sadekbaroudi/vik/pcb/vik-splitter/vik-splitter.kicad_pcb

## KiCad design pcb/vik-splitter/vik-splitter.kicad_pcb (2025-03-19)

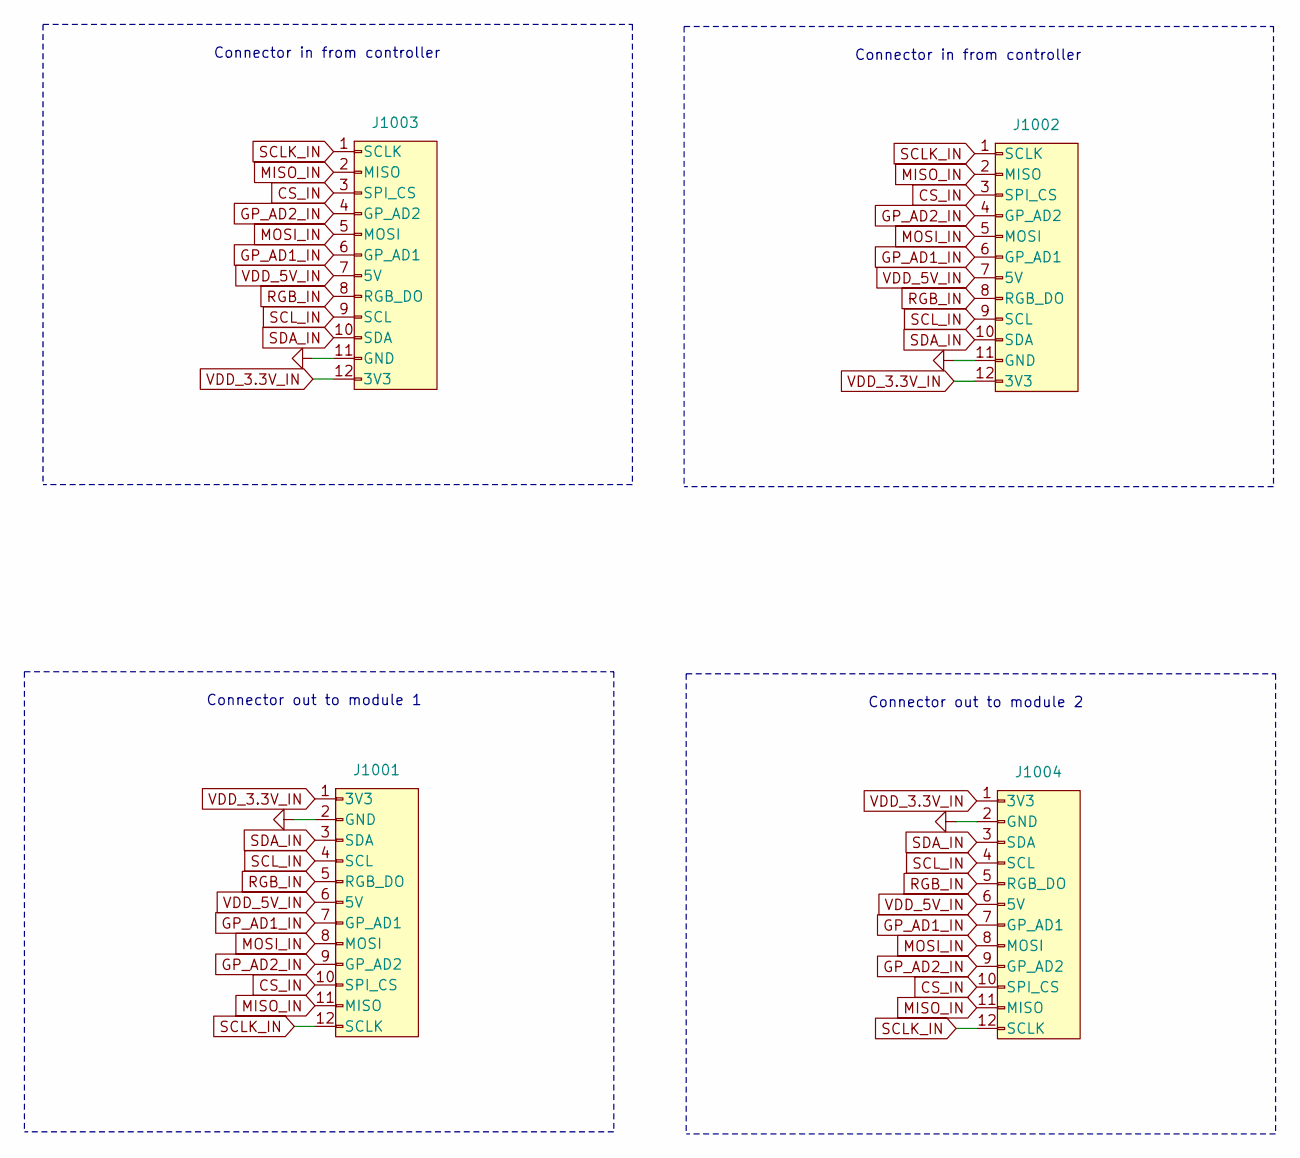
[picture p4: schematic vik-splitter.kicad_sch]

Parts:
J1001, J1004: vik-keyboard-connector-horizontal; LCSC C2919557
J1002: vik-module-throughole; LCSC C2919557
J1003: vik-module-connector-horizontal; LCSC C2919557

Connections:
CS_IN: J1001.10 (SPI_CS), J1002.3 (SPI_CS), J1003.3 (SPI_CS), J1004.10 (SPI_CS)
GND: J1001.2 (GND), J1002.11 (GND), J1003.11 (GND), J1004.2 (GND)
GP_AD1_IN: J1001.7 (GP_AD1), J1002.6 (GP_AD1), J1003.6 (GP_AD1), J1004.7 (GP_AD1)
GP_AD2_IN: J1001.9 (GP_AD2), J1002.4 (GP_AD2), J1003.4 (GP_AD2), J1004.9 (GP_AD2)
MISO_IN: J1001.11 (MISO), J1002.2 (MISO), J1003.2 (MISO), J1004.11 (MISO)
MOSI_IN: J1001.8 (MOSI), J1002.5 (MOSI), J1003.5 (MOSI), J1004.8 (MOSI)
RGB_IN: J1001.5 (RGB_DO), J1002.8 (RGB_DO), J1003.8 (RGB_DO), J1004.5 (RGB_DO)
SCLK_IN: J1001.12 (SCLK), J1002.1 (SCLK), J1003.1 (SCLK), J1004.12 (SCLK)
SCL_IN: J1001.4 (SCL), J1002.9 (SCL), J1003.9 (SCL), J1004.4 (SCL)
SDA_IN: J1001.3 (SDA), J1002.10 (SDA), J1003.10 (SDA), J1004.3 (SDA)
VDD_3.3V_IN: J1001.1 (3V3), J1002.12 (3V3), J1003.12 (3V3), J1004.1 (3V3)
VDD_5V_IN: J1001.6 (5V), J1002.7 (5V), J1003.7 (5V), J1004.6 (5V)

Notes on the sheet:
Connector out to module 2
Connector out to module 1
Connector in from controller

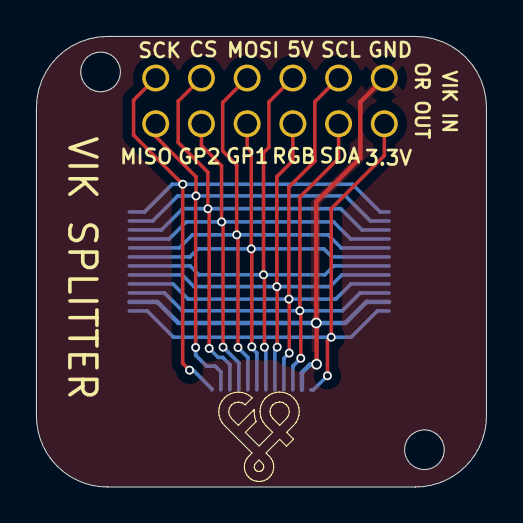
[picture p5: board vik-splitter.kicad_pcb from above]

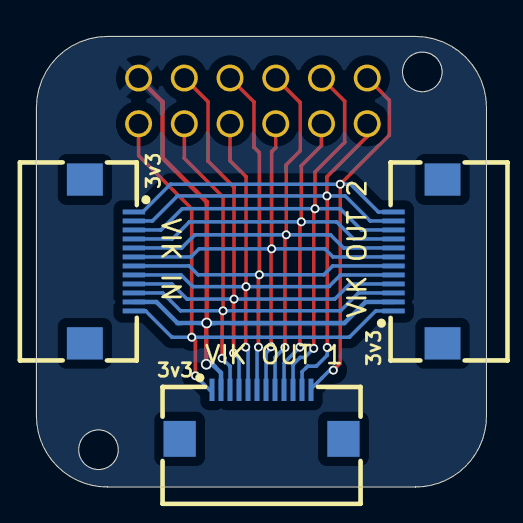
[picture p6: board vik-splitter.kicad_pcb from below]

Board: 2 copper layers, 25.0 x 25.0 mm, 4 parts (3 on the bottom side), 12 nets.
