sadekbaroudi/vik/pcb/solenoid/solenoid.kicad_pcb

## KiCad design pcb/solenoid/solenoid.kicad_pcb (2024-07-15)

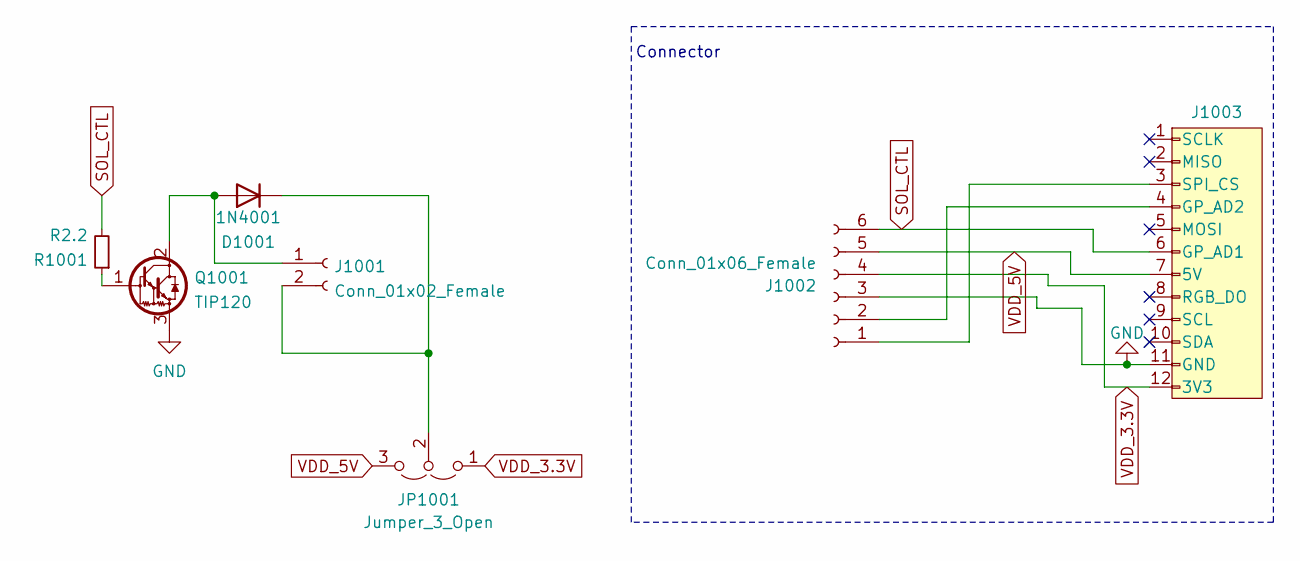
[picture p7: schematic solenoid.kicad_sch]

Parts:
D1001: 1N4001; D_DO-41_SOD81_P7.62mm_Horizontal
J1001: Conn_01x02_Female; PinHeader_1x02_P2.54mm_Vertical
J1002: Conn_01x06_Female; PinHeader_1x06_P2.54mm_Vertical
J1003: vik-module-connector-horizontal; LCSC C479750
JP1001: Jumper_3_Open; SolderJumper-3_P1.3mm_Open_RoundedPad1.0x1.5mm
Q1001: TIP120; TO-220-3_Vertical
R1001: R2.2; R_Axial_DIN0204_L3.6mm_D1.6mm_P7.62mm_Horizontal

Connections:
GND: J1002.3, J1003.11 (GND), Q1001.3 (E)
unnamed: D1001.2 (A), J1001.1, Q1001.2 (C)
unnamed: D1001.1 (K), J1001.2, JP1001.2 (C)
unnamed: J1002.1, J1003.3 (SPI_CS)
unnamed: J1002.2, J1003.4 (GP_AD2)
unnamed: Q1001.1 (B), R1001.1
SOL_CTL: J1002.6, J1003.6 (GP_AD1), R1001.2
VDD_3.3V: J1002.4, J1003.12 (3V3), JP1001.1 (A)
VDD_5V: J1002.5, J1003.7 (5V), JP1001.3 (B)

Notes on the sheet:
Connector

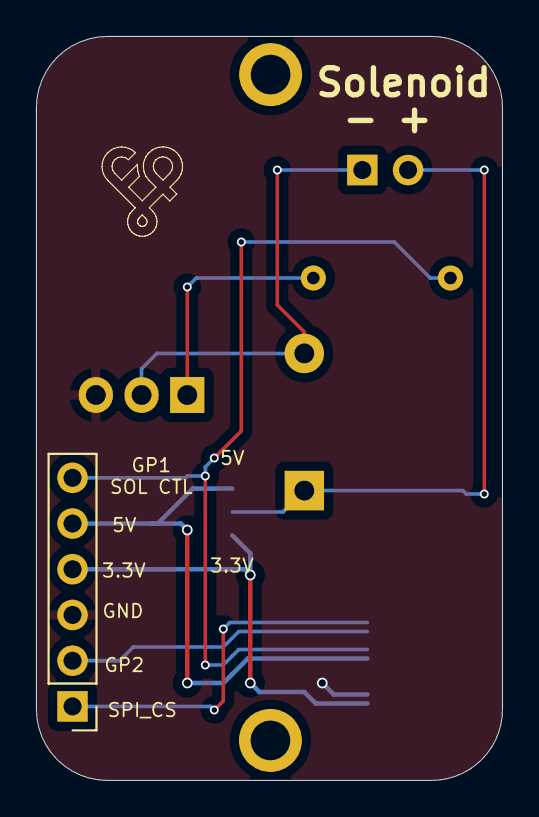
[picture p8: board solenoid.kicad_pcb from above]

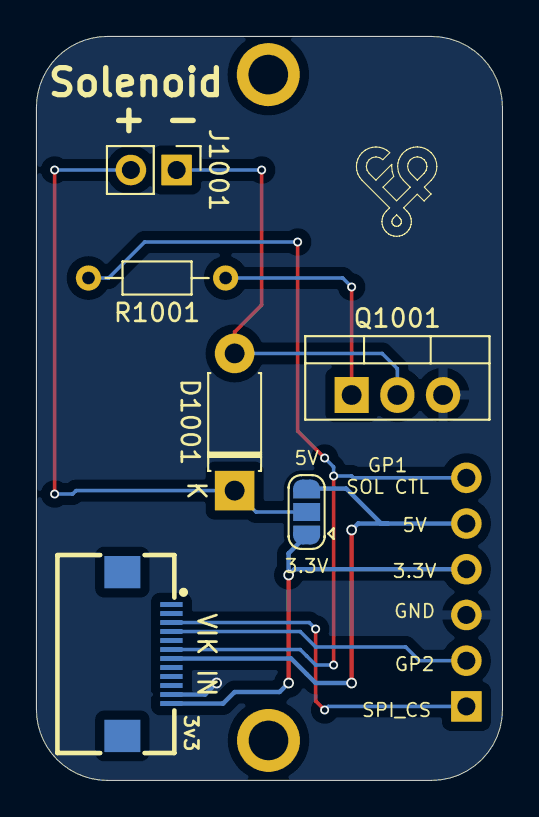
[picture p9: board solenoid.kicad_pcb from below]

Board: 2 copper layers, 25.9 x 41.3 mm, 7 parts (6 on the bottom side), 9 nets.
