sadekbaroudi/vik/pcb/pmw3360-xs/pmw3360.kicad_pcb

## KiCad design pcb/pmw3360-xs/pmw3360.kicad_pcb (2024-06-15)

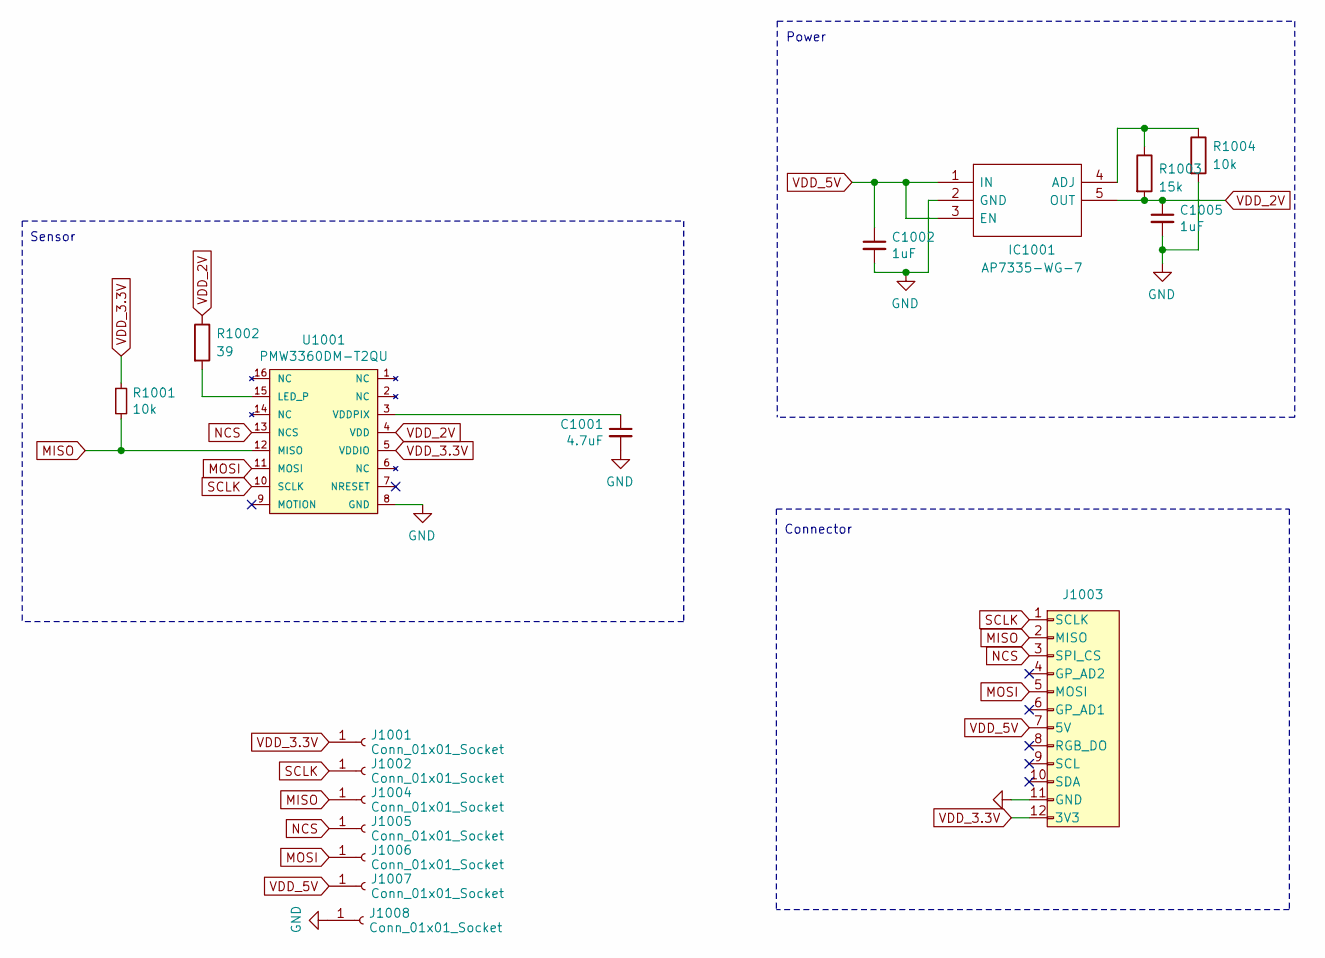
[picture p10: schematic pmw3360.kicad_sch]

Parts:
C1001: 4.7uF; C_0603_1608Metric; LCSC C19666
C1002, C1005: 1uF; C_0603_1608Metric; LCSC C15849
IC1001: AP7335-WG-7; SOT-23-5_HandSoldering; Manufacturer_Part_Number AP7331-WG-7; Mouser Part Number 621-AP7331-WG-7
J1001, J1002, J1004, J1005, J1006, J1007, J1008: Conn_01x01_Socket; SolderWire-0.5sqmm_1x01_D0.9mm_OD2.3mm
J1003: vik-module-connector-horizontal; LCSC C2919557
R1001, R1004: 10k; R_0603_1608Metric; LCSC C25804
R1002: 39; R_0603_1608Metric; LCSC C23154
R1003: 15k; R_0603_1608Metric; LCSC C22809
U1001: PMW3360DM-T2QU; DIP-16_W10.16mm

Connections:
GND: C1001.2, C1002.2, C1005.2, IC1001.2 (GND), J1003.11 (GND), J1008.1, R1004.2, U1001.8 (GND)
MISO: J1003.2 (MISO), J1004.1, R1001.2, U1001.12 (MISO)
MOSI: J1003.5 (MOSI), J1006.1, U1001.11 (MOSI)
NCS: J1003.3 (SPI_CS), J1005.1, U1001.13 (NCS)
unnamed: IC1001.4 (ADJ), R1003.1, R1004.1
unnamed: R1002.2, U1001.15 (LED_P)
unnamed: C1001.1, U1001.3 (VDDPIX)
SCLK: J1002.1, J1003.1 (SCLK), U1001.10 (SCLK)
VDD_2V: C1005.1, IC1001.5 (OUT), R1002.1, R1003.2, U1001.4 (VDD)
VDD_3.3V: J1001.1, J1003.12 (3V3), R1001.1, U1001.5 (VDDIO)
VDD_5V: C1002.1, IC1001.1 (IN), IC1001.3 (EN), J1003.7 (5V), J1007.1

Notes on the sheet:
Power
Sensor
Connector

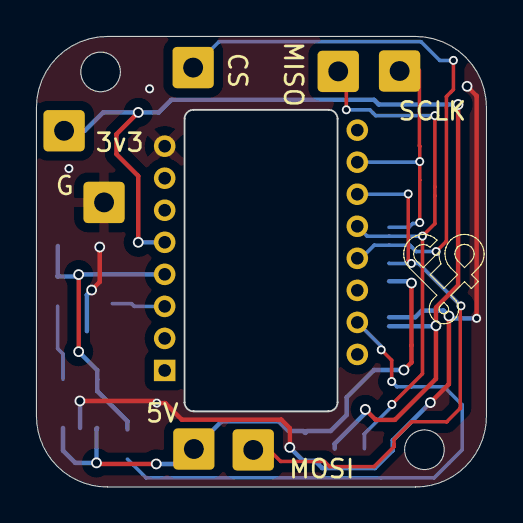
[picture p11: board pcb/pmw3360-xs/pmw3360.kicad_pcb from above]

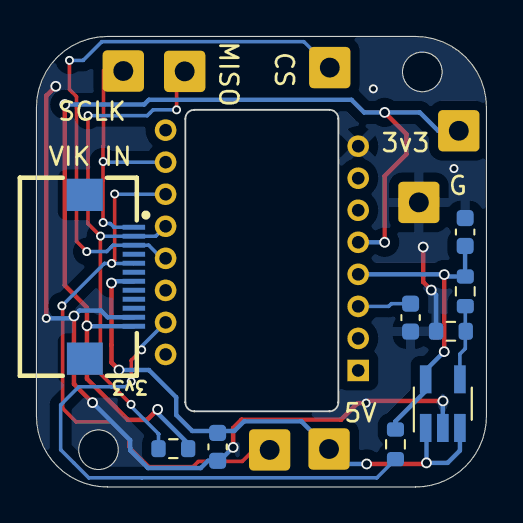
[picture p12: board pcb/pmw3360-xs/pmw3360.kicad_pcb from below]

Board: 2 copper layers, 25.0 x 25.0 mm, 17 parts (10 on the bottom side), 11 nets.
