sadekbaroudi/vik/pcb/pmw3610-xs/pmw3610.kicad_pcb

## KiCad design pcb/pmw3610-xs/pmw3610.kicad_pcb (2024-06-06)

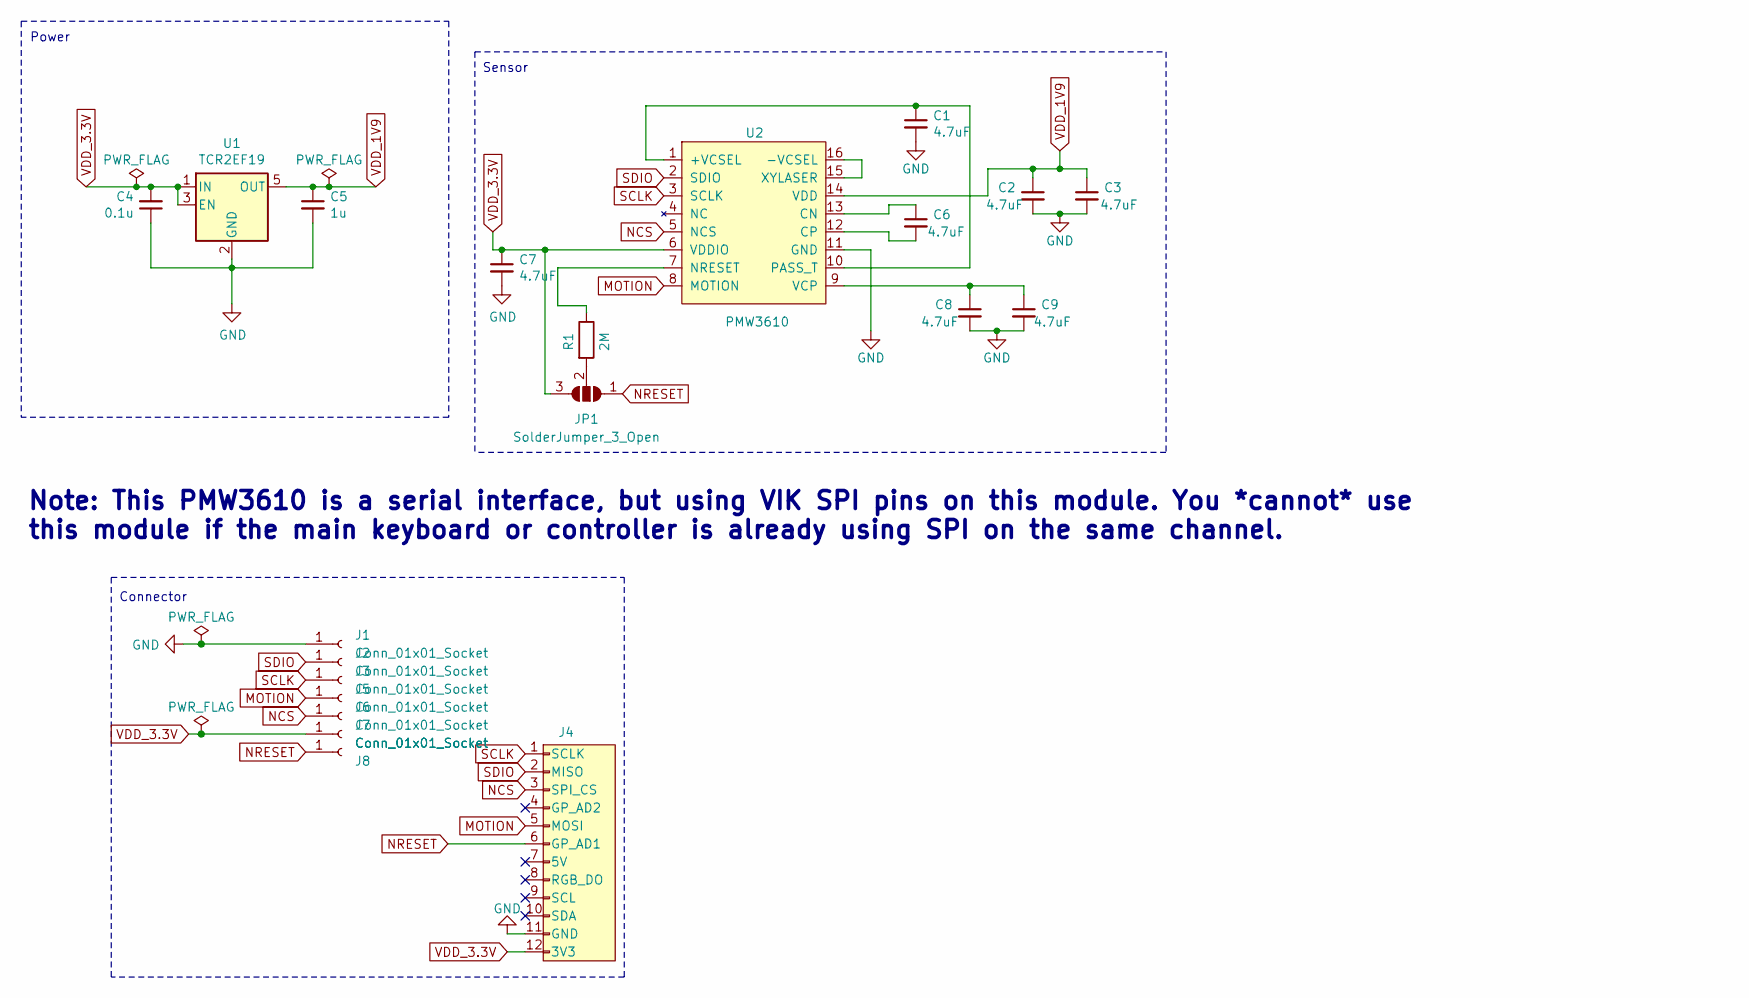
[picture p13: schematic pmw3610.kicad_sch]

Parts:
C1, C2, C3, C6, C7, C8, C9: 4.7uF; C_0603_1608Metric; LCSC C19666
C4: 0.1u; C_0603_1608Metric; LCSC C14663
C5: 1u; C_0603_1608Metric; LCSC C15849
J1, J2, J3, J5, J6, J7, J8: Conn_01x01_Socket; PinHeader_1x01_P1.00mm_NoSilk
J4: vik-module-connector-horizontal; LCSC C479750
JP1: SolderJumper_3_Open; SolderJumper-3_P1.3mm_Open_RoundedPad1.0x1.5mm_NumberLabels
R1: 2M; R_0603_1608Metric; LCSC C465466
U1: TCR2EF19; SOT-23-5; LCSC C146366
U2: PMW3610

Connections:
GND: C1.2, C2.2, C3.2, C4.1, C5.2, C7.2, C8.2, C9.2, J1.1, J4.11 (GND), U1.2 (GND), U2.11 (GND)
MOTION: J4.5 (MOSI), J5.1, U2.8 (MOTION)
NCS: J4.3 (SPI_CS), J6.1, U2.5 (NCS)
NRESET: J4.6 (GP_AD1), J8.1, JP1.1 (A)
unnamed: JP1.2 (C), R1.2
unnamed: C1.1, U2.1 (+VCSEL), U2.10 (PASS_T)
unnamed: U2.15 (XYLASER), U2.16 (-VCSEL)
unnamed: C6.1, U2.13 (CN)
unnamed: C6.2, U2.12 (CP)
unnamed: R1.1, U2.7 (NRESET)
unnamed: C8.1, C9.1, U2.9 (VCP)
SCLK: J3.1, J4.1 (SCLK), U2.3 (SCLK)
SDIO: J2.1, J4.2 (MISO), U2.2 (SDIO)
VDD_1V9: C2.1, C3.1, C5.1, U1.5 (OUT), U2.14 (VDD)
VDD_3.3V: C4.2, C7.1, J4.12 (3V3), J7.1, JP1.3 (B), U1.1 (IN), U1.3 (EN), U2.6 (VDDIO)

Notes on the sheet:
Connector
Power
Note: This PMW3610 is a serial interface, but using VIK SPI pins on this module. You *cannot* use this module if the main keyboard or controller is already using SPI on the same channel.
Sensor

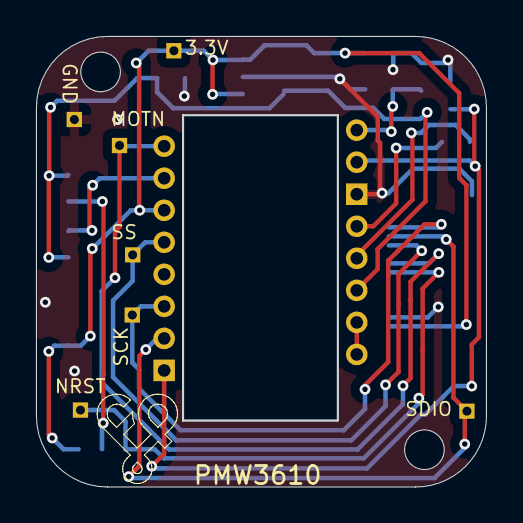
[picture p14: board pmw3610.kicad_pcb from above]

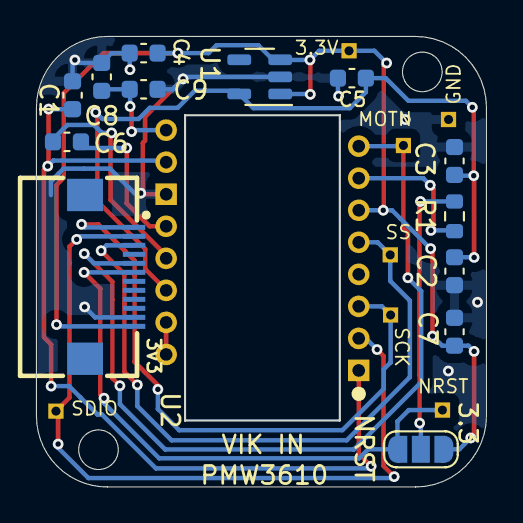
[picture p15: board pmw3610.kicad_pcb from below]

Board: 2 copper layers, 25.0 x 25.0 mm, 21 parts (14 on the bottom side), 15 nets.
