sadekbaroudi/vik/pcb/ili9341v/ili9341v.kicad_pcb

## KiCad design pcb/ili9341v/ili9341v.kicad_pcb (2024-05-15)

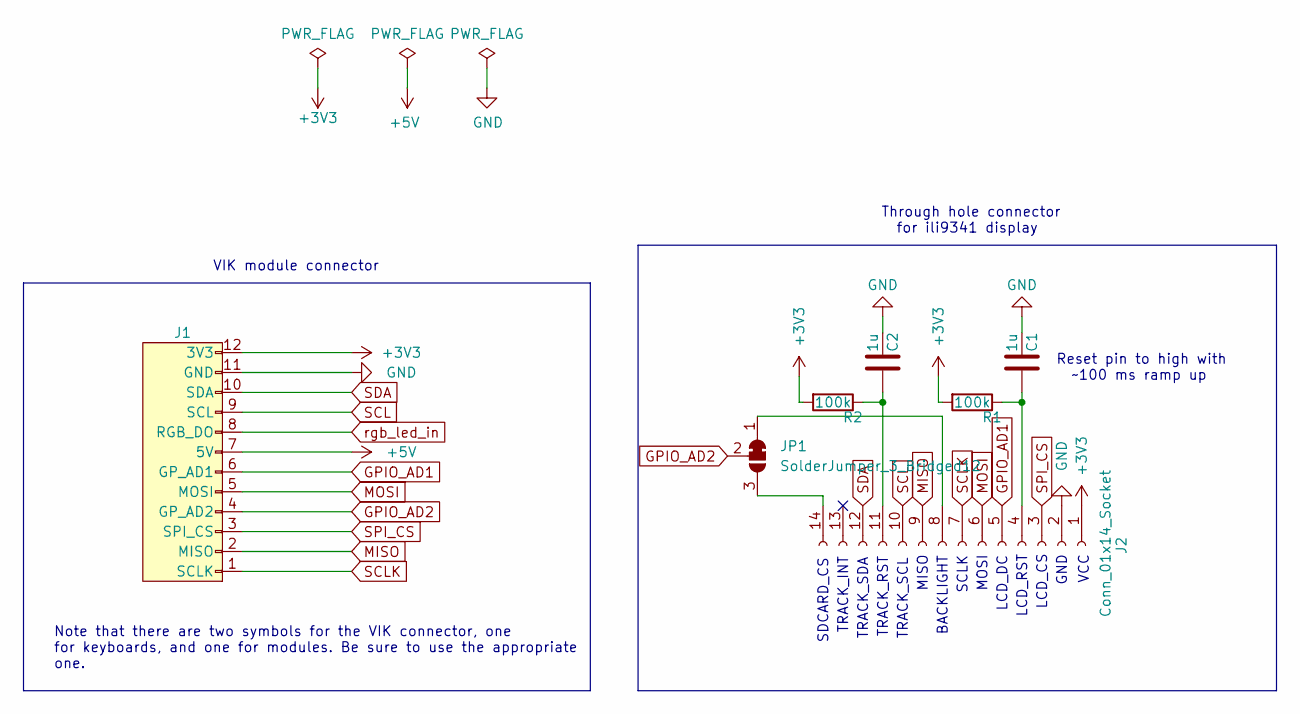
[picture p16: schematic ili9341v.kicad_sch]

Parts:
C1, C2: 1u; C_1206_3216Metric_Pad1.33x1.80mm_HandSolder; MPN CL05A105KA5NQNC; LCSC C90539
J1: vik-module-connector-horizontal; LCSC C479750
J2: Conn_01x14_Socket; PinHeader_1x14_P2.54mm_Vertical
JP1: SolderJumper_3_Bridged12; SolderJumper-3_P1.3mm_Bridged12_RoundedPad1.0x1.5mm_NumberL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
R1, R2: 100k; R_1206_3216Metric_Pad1.30x1.75mm_HandSolder; LCSC C17900

Connections:
+3V3: J1.12 (3V3), J2.1, R1.2, R2.2
+5V: J1.7 (5V)
GND: C1.1, C2.1, J1.11 (GND), J2.2
GPIO_AD1: J1.6 (GP_AD1), J2.5
GPIO_AD2: J1.4 (GP_AD2), JP1.2 (C)
MISO: J1.2 (MISO), J2.9
MOSI: J1.5 (MOSI), J2.6
unnamed: C1.2, J2.4, R1.1
unnamed: J2.8, JP1.1 (A)
unnamed: C2.2, J2.11, R2.1
unnamed: J2.14, JP1.3 (B)
SCL: J1.9 (SCL), J2.10
SCLK: J1.1 (SCLK), J2.7
SDA: J1.10 (SDA), J2.12
SPI_CS: J1.3 (SPI_CS), J2.3
rgb_led_in: J1.8 (RGB_DO)

Notes on the sheet:
LCD_DC
VCC
TRACK_INT
TRACK_SDA
LCD_CS
SCLK
Note that there are two symbols for the VIK connector, one for keyboards, and one for modules. Be sure to use the appropriate one.
Through hole connector for ili9341 display
MOSI
SDCARD_CS
BACKLIGHT
VIK module connector
Reset pin to high with ~100 ms ramp up
LCD_RST
GND
TRACK_RST
MISO
TRACK_SCL

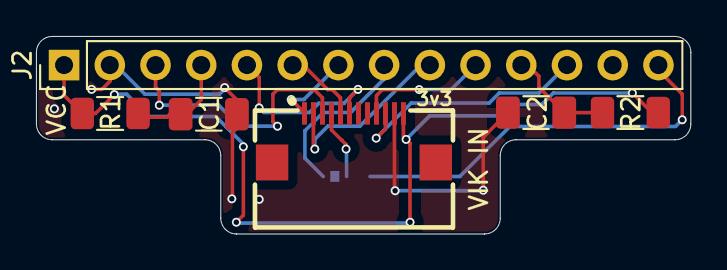
[picture p17: board ili9341v.kicad_pcb from above]

Board: 2 copper layers, 36.4 x 11.0 mm, 7 parts (1 on the bottom side), 14 nets.
