sadekbaroudi/vik/pcb/haptic-drv2605l/haptic-drv2605l.kicad_pcb

## KiCad design pcb/haptic-drv2605l/haptic-drv2605l.kicad_pcb (2024-05-06)

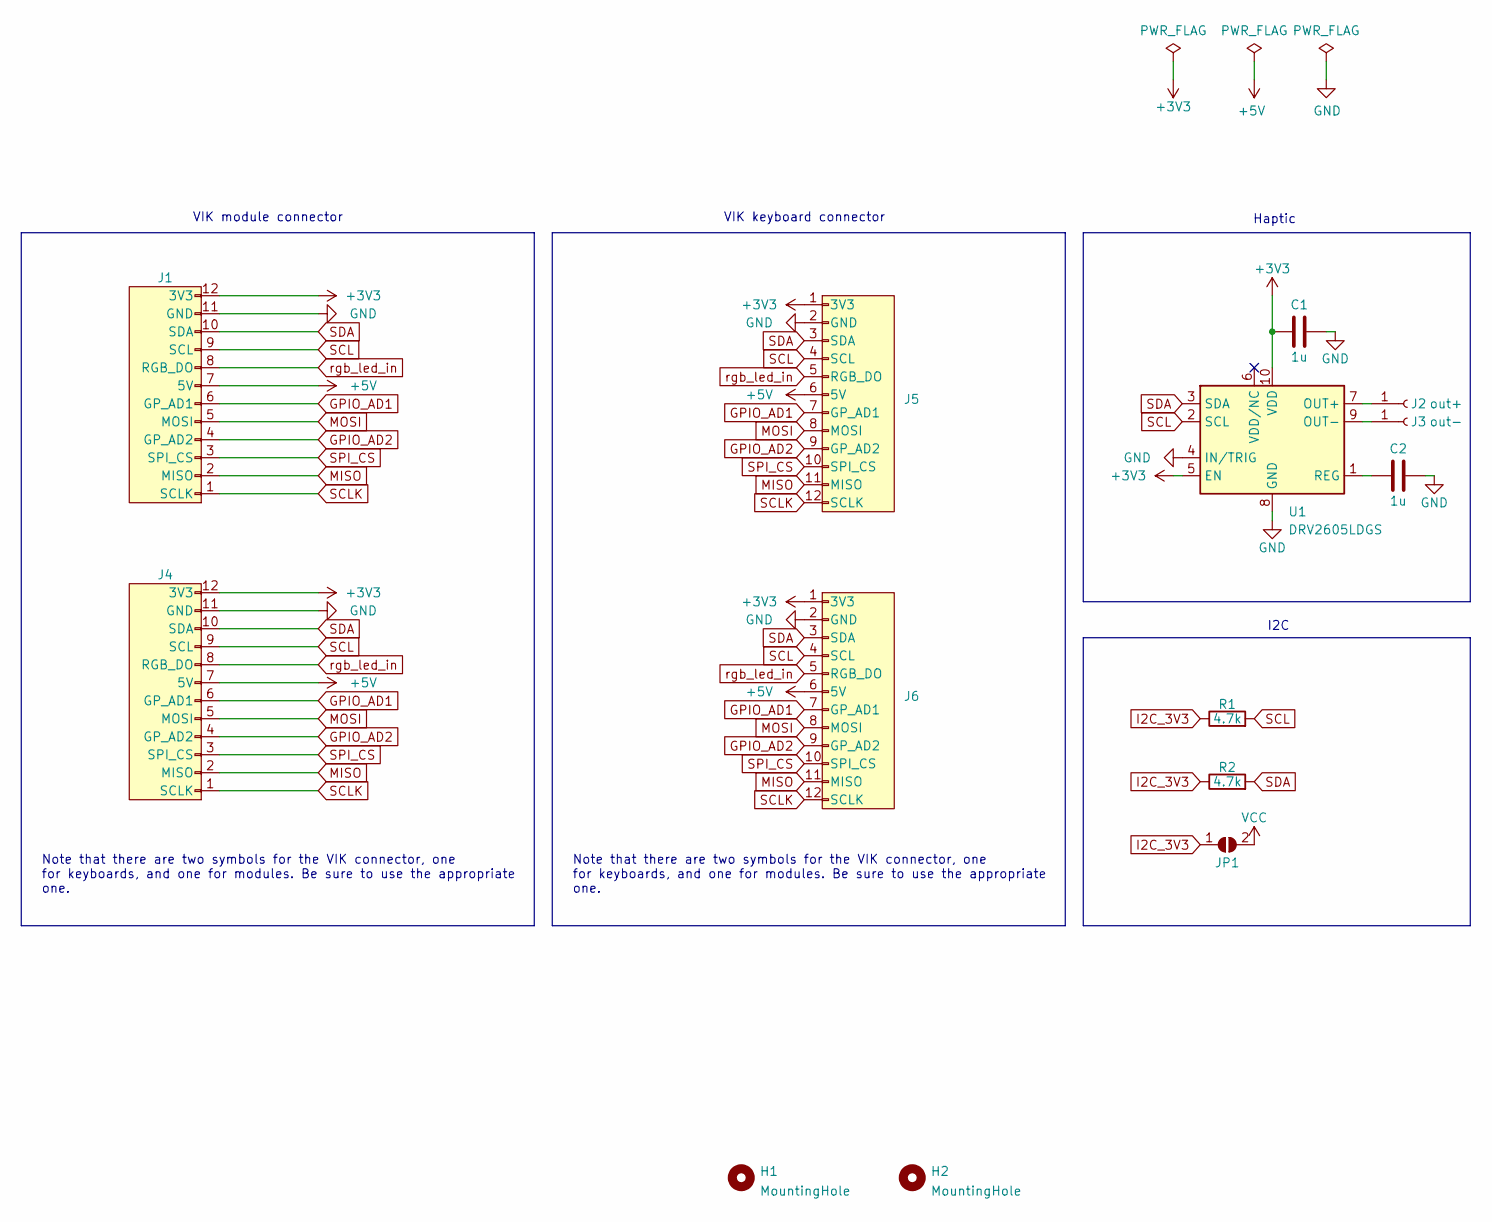
[picture p18: schematic haptic-drv2605l.kicad_sch]

Parts:
C1, C2: 1u; C_1206_3216Metric
H1, H2: MountingHole; MountingHole_2.2mm_M2_DIN965_Pad
J1: vik-module-connector-horizontal; LCSC C479750
J2: out+; TestPoint_THTPad_D2.0mm_Drill1.0mm
J3: out-; TestPoint_THTPad_D2.0mm_Drill1.0mm
J4: vik-module-connector-vertical; LCSC C479750
J5: vik-keyboard-connector-horizontal
J6: vik-keyboard-connector-vertical
JP1: VCC; SolderJumper-2_P1.3mm_Open_RoundedPad1.0x1.5mm
R1, R2: 4.7k; R_1206_3216Metric
U1: DRV2605LDGS; VSSOP-10_3x3mm_P0.5mm

Connections:
+3V3: C1.1, J1.12 (3V3), J4.12 (3V3), J5.1 (3V3), J6.1 (3V3), U1.5 (EN), U1.10 (VDD)
+5V: J1.7 (5V), J4.7 (5V), J5.6 (5V), J6.6 (5V)
GND: C1.2, C2.2, J1.11 (GND), J4.11 (GND), J5.2 (GND), J6.2 (GND), U1.4 (IN/TRIG), U1.8 (GND)
GPIO_AD1: J1.6 (GP_AD1), J4.6 (GP_AD1), J5.7 (GP_AD1), J6.7 (GP_AD1)
GPIO_AD2: J1.4 (GP_AD2), J4.4 (GP_AD2), J5.9 (GP_AD2), J6.9 (GP_AD2)
I2C_3V3: JP1.1 (A), R1.1, R2.1
MISO: J1.2 (MISO), J4.2 (MISO), J5.11 (MISO), J6.11 (MISO)
MOSI: J1.5 (MOSI), J4.5 (MOSI), J5.8 (MOSI), J6.8 (MOSI)
unnamed: J2.1, U1.7 (OUT+)
unnamed: J3.1, U1.9 (OUT-)
unnamed: C2.1, U1.1 (REG)
SCL: J1.9 (SCL), J4.9 (SCL), J5.4 (SCL), J6.4 (SCL), R1.2, U1.2 (SCL)
SCLK: J1.1 (SCLK), J4.1 (SCLK), J5.12 (SCLK), J6.12 (SCLK)
SDA: J1.10 (SDA), J4.10 (SDA), J5.3 (SDA), J6.3 (SDA), R2.2, U1.3 (SDA)
SPI_CS: J1.3 (SPI_CS), J4.3 (SPI_CS), J5.10 (SPI_CS), J6.10 (SPI_CS)
VCC: JP1.2 (B)
rgb_led_in: J1.8 (RGB_DO), J4.8 (RGB_DO), J5.5 (RGB_DO), J6.5 (RGB_DO)

Notes on the sheet:
Note that there are two symbols for the VIK connector, one for keyboards, and one for modules. Be sure to use the appropriate one.
VIK keyboard connector
I2C
VIK module connector
Haptic

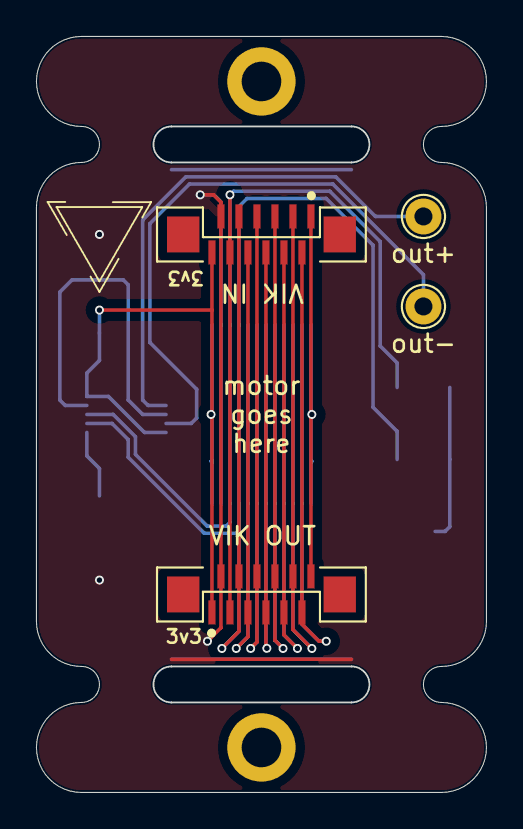
[picture p19: board haptic-drv2605l.kicad_pcb from above]

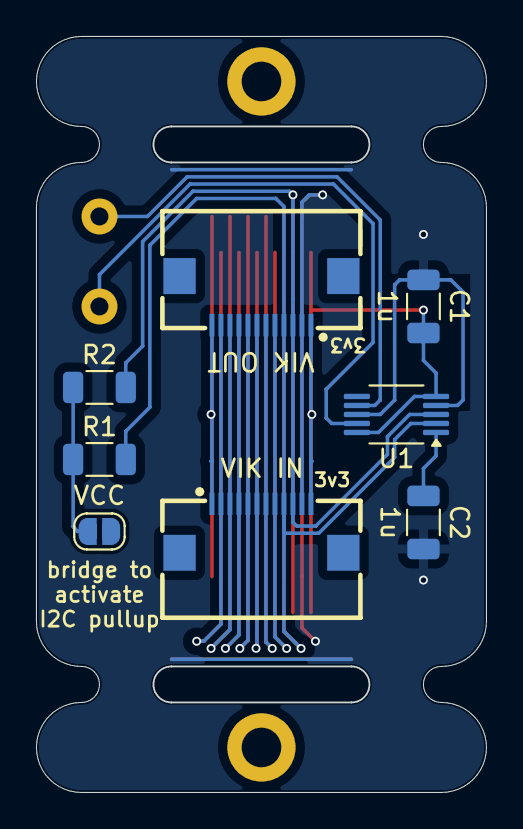
[picture p20: board haptic-drv2605l.kicad_pcb from below]

Board: 2 copper layers, 25.0 x 42.0 mm, 14 parts (8 on the bottom side), 16 nets.
