sadekbaroudi/vik/pcb/vikropad/vikropad.kicad_pcb

## KiCad design pcb/vikropad/vikropad.kicad_pcb (2024-04-18)

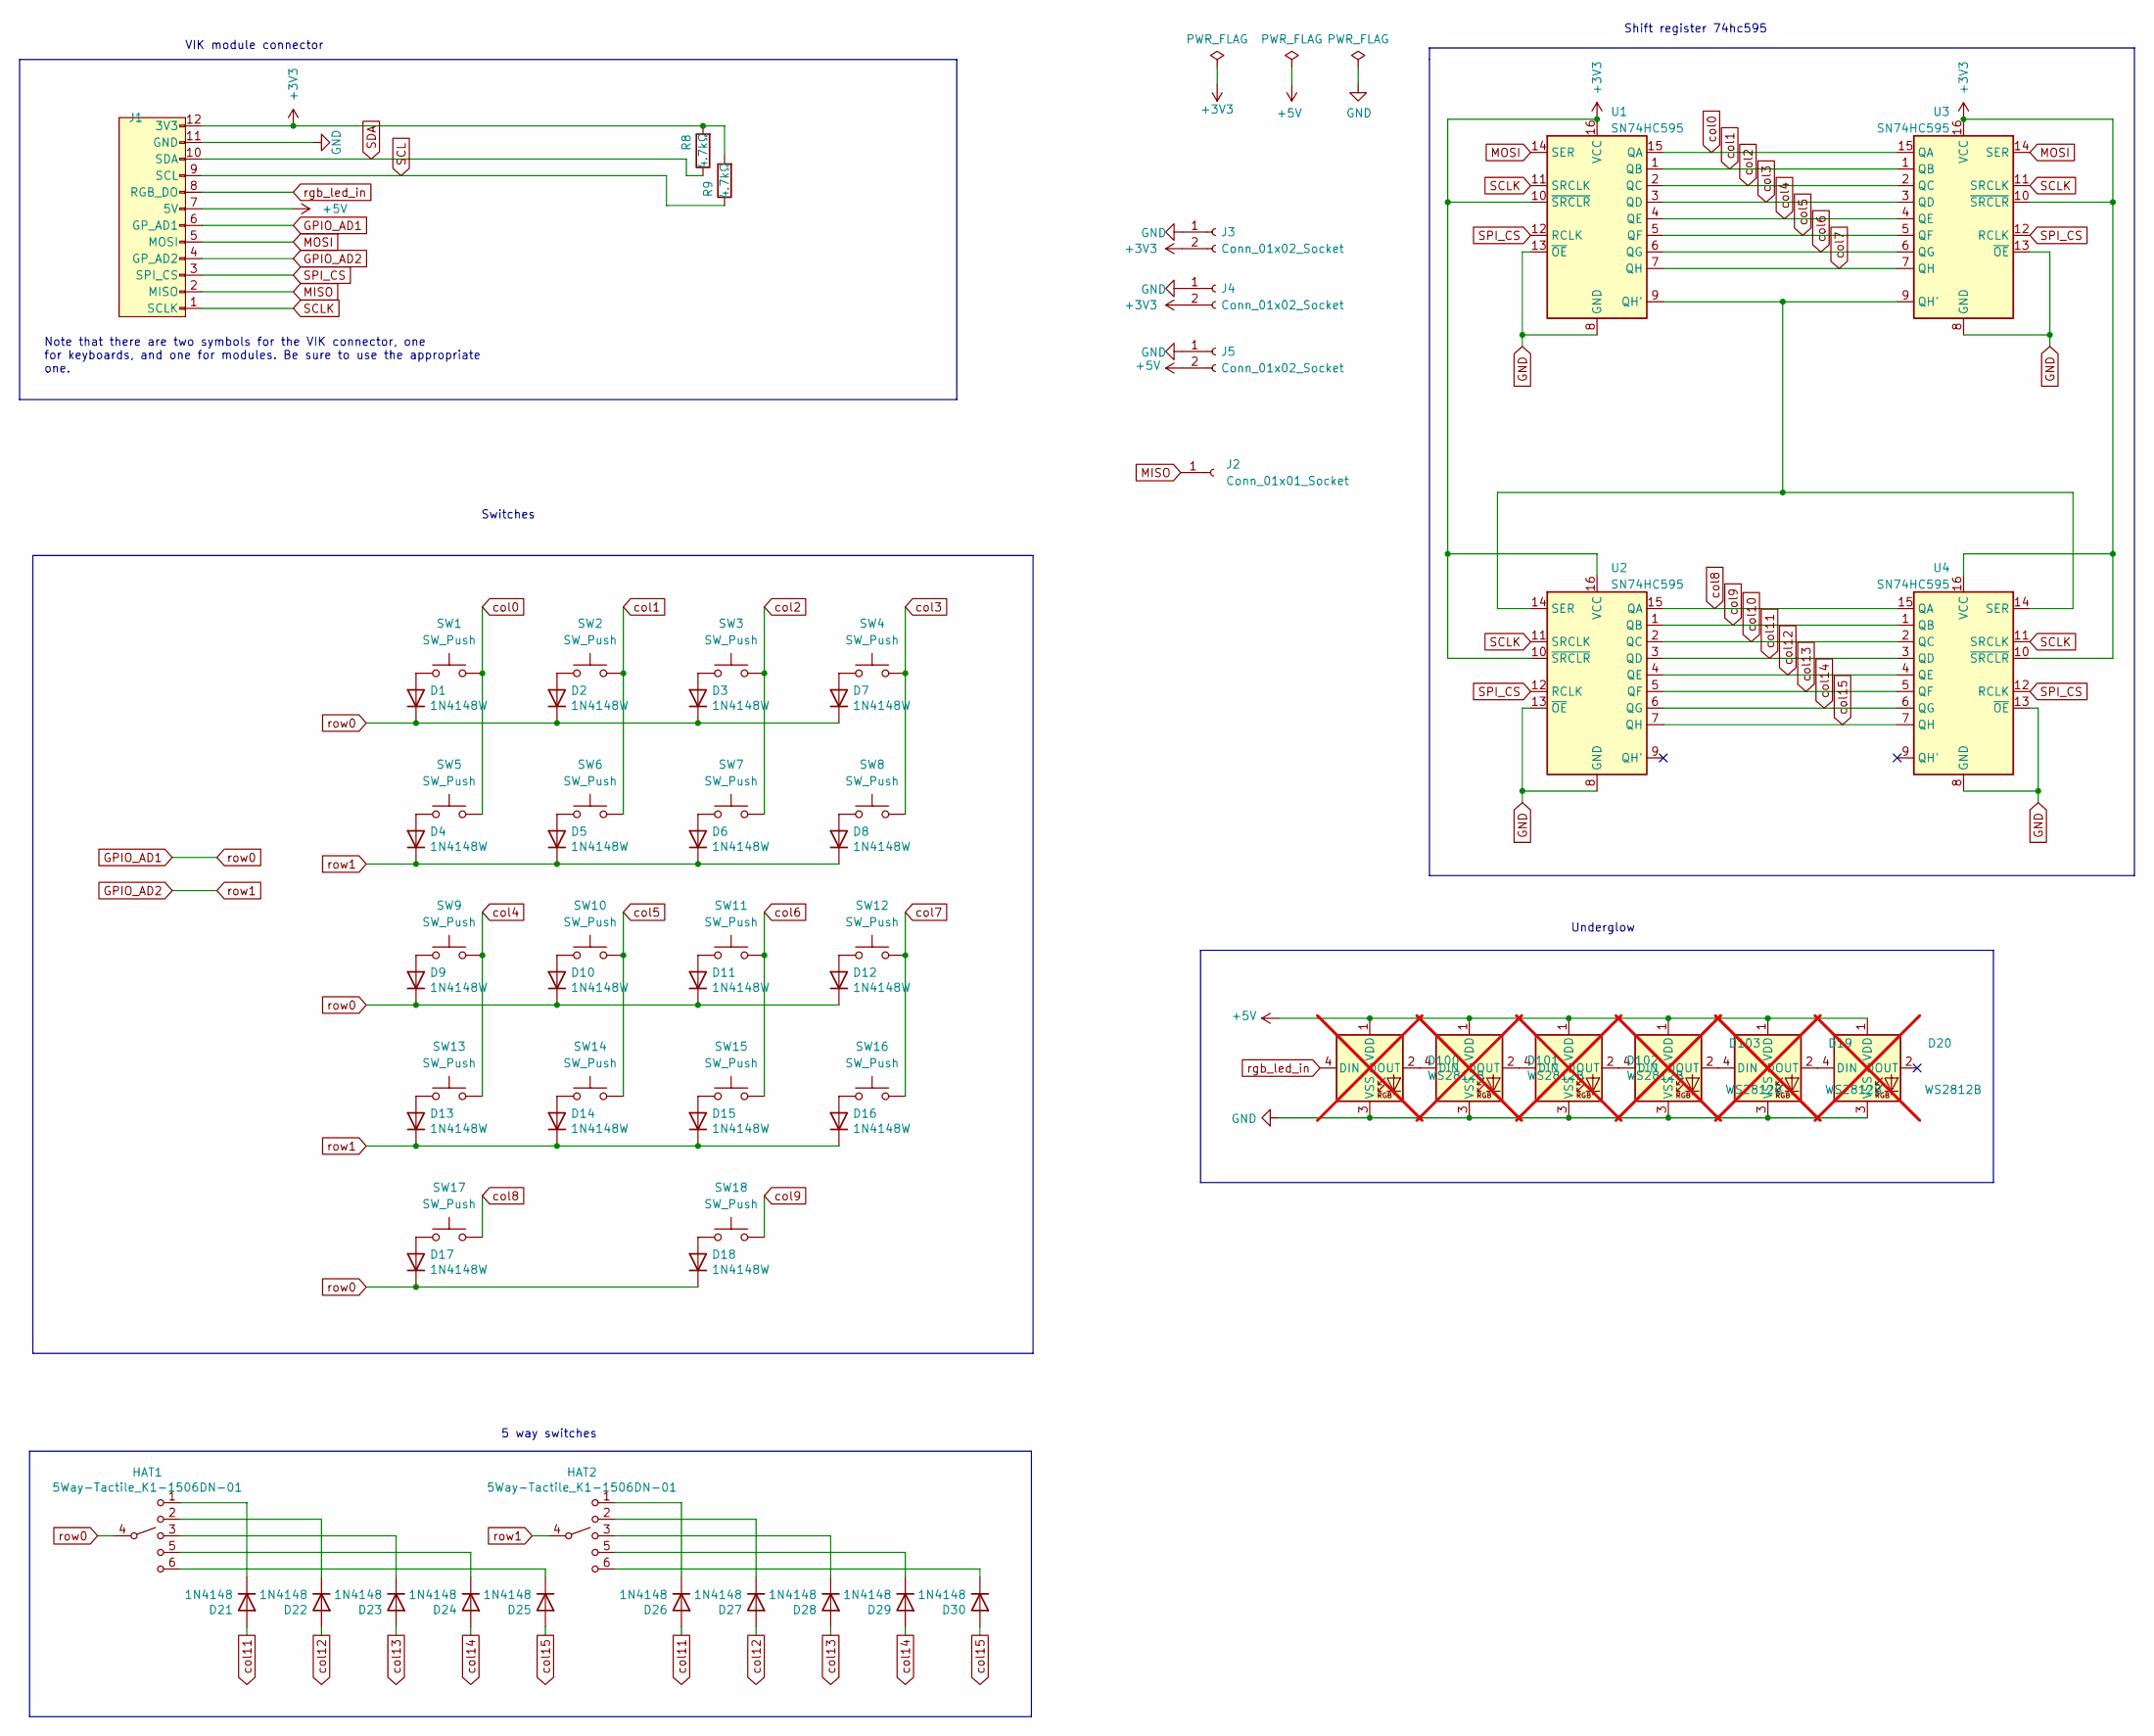
[picture p21: schematic vikropad.kicad_sch]

Parts:
D1, D2, D3, D4, D5, D6, D7, D8, D9, D10, D11, D12, D13, D14, D15, D16, D17, D18: 1N4148W; D_SOD-123; LCSC C909967
D19, D20, D100, D101, D102, D103: WS2812B; LED_WS2812B_PLCC4_5.0x5.0mm_P3.2mm; LCSC C2761795; not fitted
D21, D22, D23, D24, D25, D26, D27, D28, D29, D30: 1N4148; D_SOD-123; LCSC C8598
HAT1, HAT2: 5Way-Tactile_K1-1506DN-01
J1: vik-module-connector-horizontal; LCSC C479750
J2: Conn_01x01_Socket; PinHeader_1x01_P2.54mm_Vertical
J3, J4, J5: Conn_01x02_Socket; PinHeader_1x02_P2.54mm_Vertical
R8, R9: 4.7kΩ; R_0805_2012Metric_Pad1.20x1.40mm_HandSolder; Part Name Resistor; LCSC C17673
SW1, SW2, SW3, SW4, SW5, SW6, SW7, SW8, SW9, SW10, SW11, SW12, SW13, SW14, SW15, SW16, SW17, SW18: SW_Push; gateron-ks27-choc-v1-mx-soldered-and-hotswap
U1, U2: SN74HC595; SOIC-16_3.9x9.9mm_P1.27mm; LCSC C5947
U3, U4: SN74HC595; DIP-16_W7.62mm

Connections:
+3V3: J1.12 (3V3), J3.2, J4.2, R8.2, R9.2, U1.10 (~SRCLR), U1.16 (VCC), U2.10 (~SRCLR), U2.16 (VCC), U3.10 (~SRCLR), U3.16 (VCC), U4.10 (~SRCLR), U4.16 (VCC)
+5V: D19.1 (VDD), D20.1 (VDD), D100.1 (VDD), D101.1 (VDD), D102.1 (VDD), D103.1 (VDD), J1.7 (5V), J5.2
GND: D19.3 (VSS), D20.3 (VSS), D100.3 (VSS), D101.3 (VSS), D102.3 (VSS), D103.3 (VSS), J1.11 (GND), J3.1, J4.1, J5.1, U1.8 (GND), U1.13 (~OE), U2.8 (GND), U2.13 (~OE), U3.8 (GND), U3.13 (~OE), U4.8 (GND), U4.13 (~OE)
GPIO_AD1: D1.1 (K), D2.1 (K), D3.1 (K), D7.1 (K), D9.1 (K), D10.1 (K), D11.1 (K), D12.1 (K), D17.1 (K), D18.1 (K), HAT1.4, J1.6 (GP_AD1)
GPIO_AD2: D4.1 (K), D5.1 (K), D6.1 (K), D8.1 (K), D13.1 (K), D14.1 (K), D15.1 (K), D16.1 (K), HAT2.4, J1.4 (GP_AD2)
MISO: J1.2 (MISO), J2.1
MOSI: J1.5 (MOSI), U1.14 (SER), U3.14 (SER)
unnamed: D1.2 (A), SW1.1
unnamed: D2.2 (A), SW2.1
unnamed: D3.2 (A), SW3.1
unnamed: D4.2 (A), SW5.1
unnamed: D5.2 (A), SW6.1
unnamed: D6.2 (A), SW7.1
unnamed: D7.2 (A), SW4.1
unnamed: D8.2 (A), SW8.1
unnamed: D9.2 (A), SW9.1
unnamed: D10.2 (A), SW10.1
unnamed: D11.2 (A), SW11.1
unnamed: D12.2 (A), SW12.1
unnamed: D13.2 (A), SW13.1
unnamed: D14.2 (A), SW14.1
unnamed: D15.2 (A), SW15.1
unnamed: D16.2 (A), SW16.1
unnamed: D17.2 (A), SW17.1
unnamed: D18.2 (A), SW18.1
unnamed: D19.2 (DOUT), D20.4 (DIN)
unnamed: D21.1 (K), HAT1.1
unnamed: D22.1 (K), HAT1.2
unnamed: D23.1 (K), HAT1.3
unnamed: D24.1 (K), HAT1.5
unnamed: D25.1 (K), HAT1.6
unnamed: D26.1 (K), HAT2.1
unnamed: D27.1 (K), HAT2.2
unnamed: D28.1 (K), HAT2.3
unnamed: D29.1 (K), HAT2.5
unnamed: D30.1 (K), HAT2.6
unnamed: D100.2 (DOUT), D101.4 (DIN)
unnamed: D101.2 (DOUT), D102.4 (DIN)
unnamed: D102.2 (DOUT), D103.4 (DIN)
unnamed: D19.4 (DIN), D103.2 (DOUT)
unnamed: U1.9 (QH'), U2.14 (SER), U3.9 (QH'), U4.14 (SER)
SCL: J1.9 (SCL), R9.1
SCLK: J1.1 (SCLK), U1.11 (SRCLK), U2.11 (SRCLK), U3.11 (SRCLK), U4.11 (SRCLK)
SDA: J1.10 (SDA), R8.1
SPI_CS: J1.3 (SPI_CS), U1.12 (RCLK), U2.12 (RCLK), U3.12 (RCLK), U4.12 (RCLK)
col0: SW1.2, SW5.2, U1.15 (QA), U3.15 (QA)
col1: SW2.2, SW6.2, U1.1 (QB), U3.1 (QB)
col2: SW3.2, SW7.2, U1.2 (QC), U3.2 (QC)
col3: SW4.2, SW8.2, U1.3 (QD), U3.3 (QD)
col4: SW9.2, SW13.2, U1.4 (QE), U3.4 (QE)
col5: SW10.2, SW14.2, U1.5 (QF), U3.5 (QF)
col6: SW11.2, SW15.2, U1.6 (QG), U3.6 (QG)
col7: SW12.2, SW16.2, U1.7 (QH), U3.7 (QH)
col8: SW17.2, U2.15 (QA), U4.15 (QA)
col9: SW18.2, U2.1 (QB), U4.1 (QB)
col10: U2.2 (QC), U4.2 (QC)
col11: D21.2 (A), D26.2 (A), U2.3 (QD), U4.3 (QD)
col12: D22.2 (A), D27.2 (A), U2.4 (QE), U4.4 (QE)
col13: D23.2 (A), D28.2 (A), U2.5 (QF), U4.5 (QF)
col14: D24.2 (A), D29.2 (A), U2.6 (QG), U4.6 (QG)
col15: D25.2 (A), D30.2 (A), U2.7 (QH), U4.7 (QH)
rgb_led_in: D100.4 (DIN), J1.8 (RGB_DO)

Notes on the sheet:
Shift register 74hc595
Note that there are two symbols for the VIK connector, one for keyboards, and one for modules. Be sure to use the appropriate one.
Switches
Underglow
VIK module connector
5 way switches

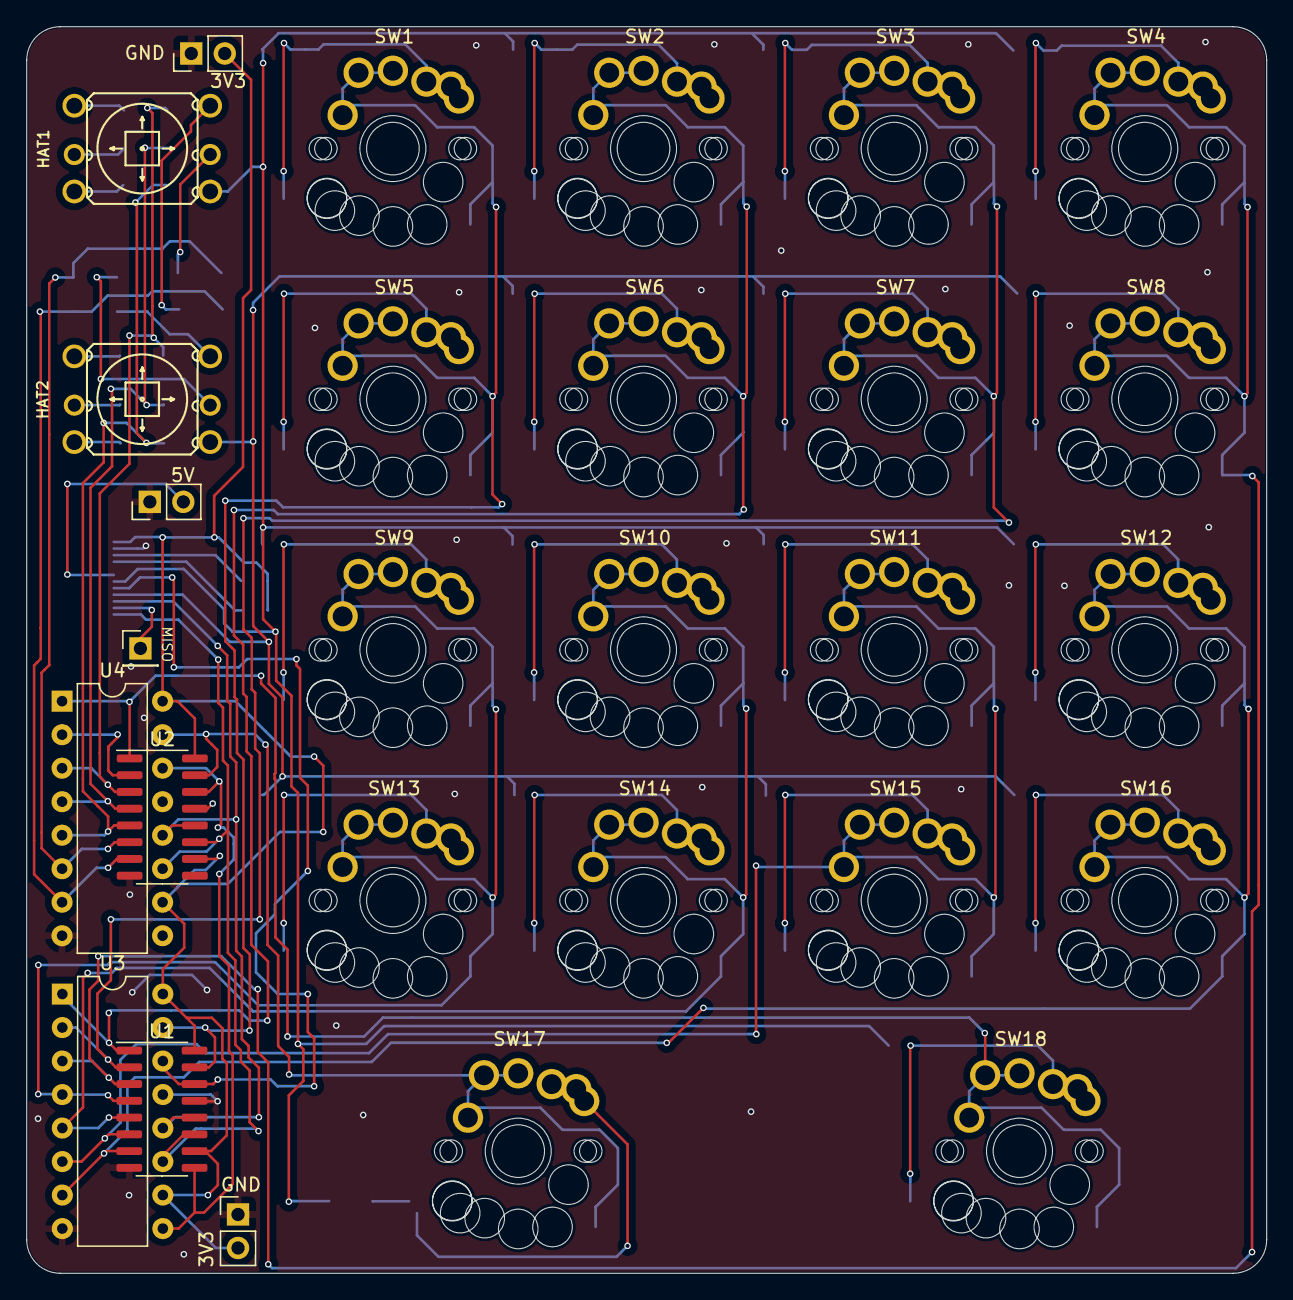
[picture p22: board vikropad.kicad_pcb from above]

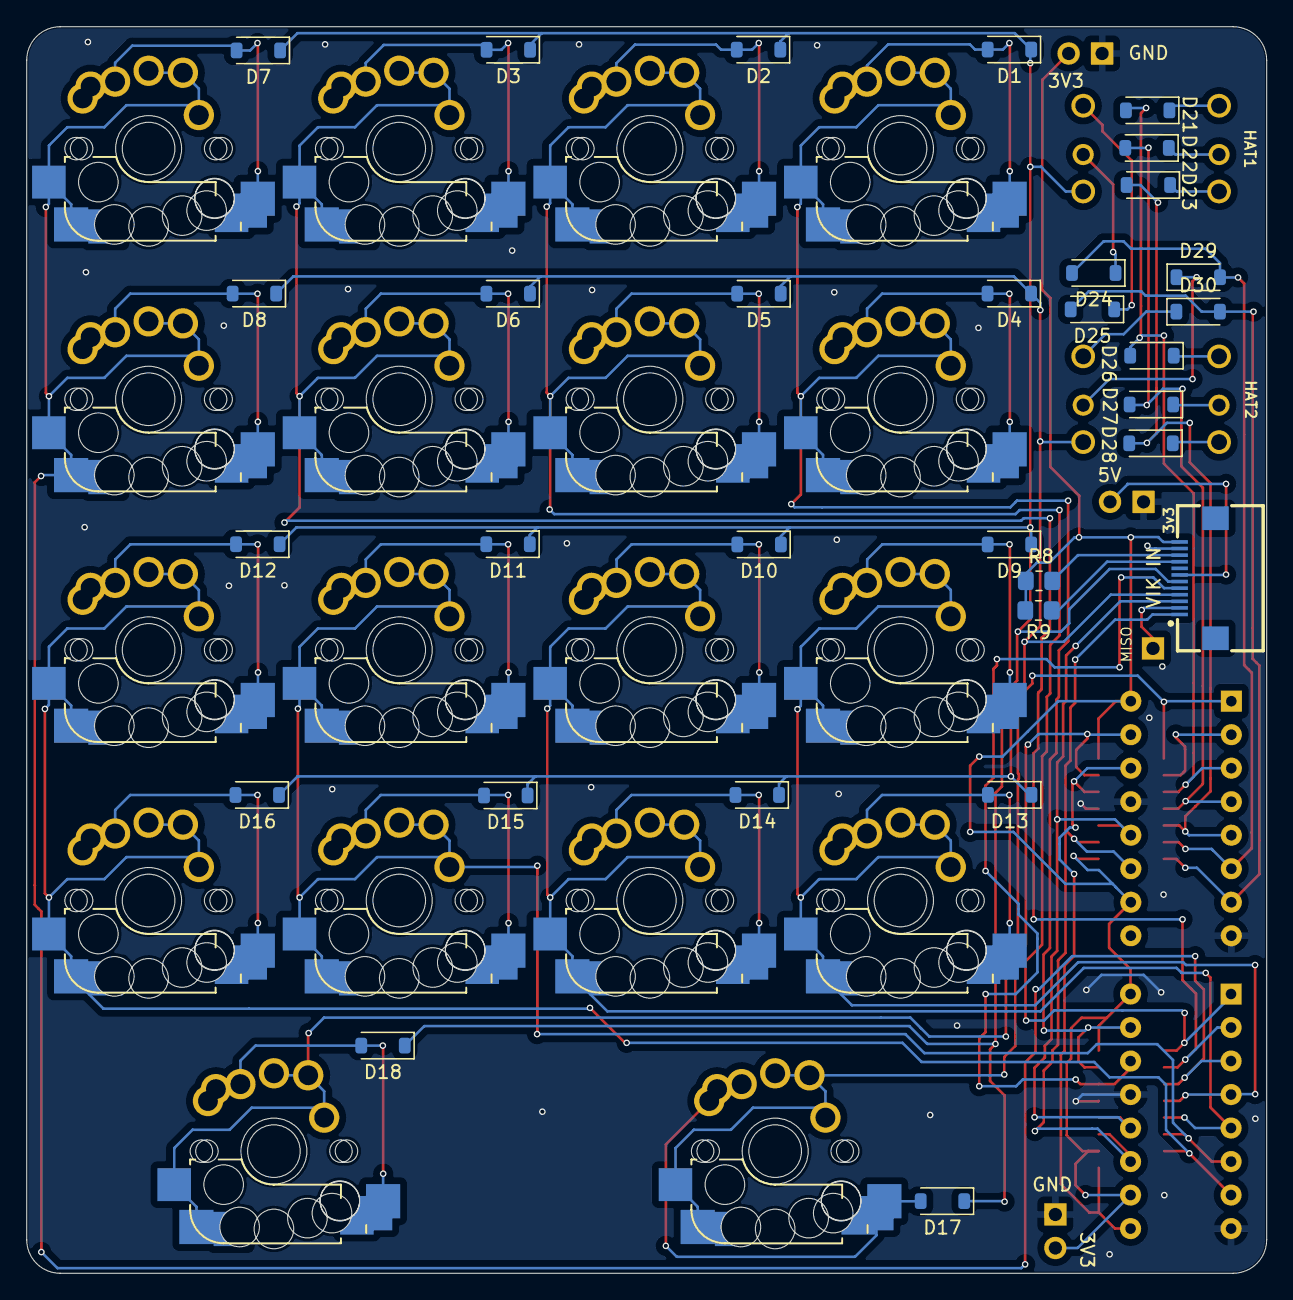
[picture p23: board vikropad.kicad_pcb from below]

Board: 2 copper layers, 94.0 x 94.5 mm, 59 parts (31 on the bottom side), 56 nets.
