sadekbaroudi/vik/pcb/azoteq-tps/vertical-fpc/azoteq-tps.kicad_pcb

## KiCad design pcb/azoteq-tps/vertical-fpc/azoteq-tps.kicad_pcb (2024-03-22)

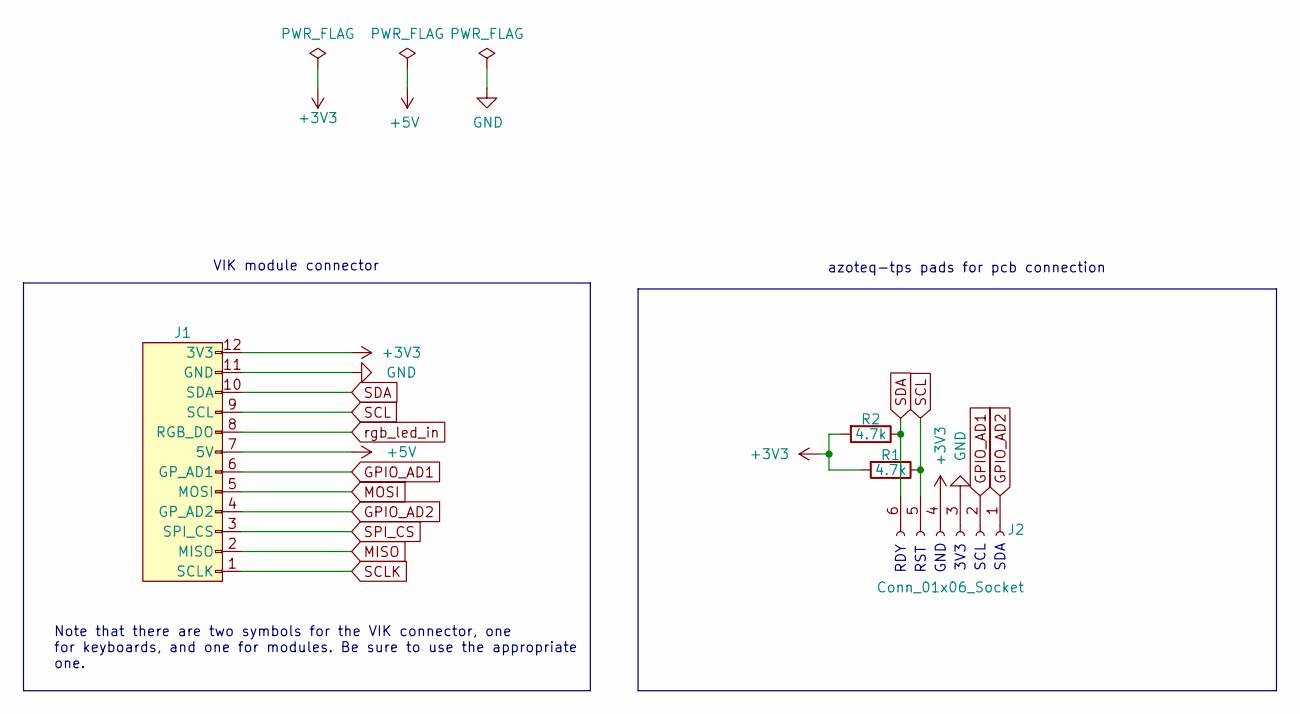
[picture p24: schematic azoteq-tps.kicad_sch]

Parts:
J1: vik-module-connector-vertical; LCSC C2919479
J2: Conn_01x06_Socket; Pad_06_2.00mm
R1, R2: 4.7k; R_0805_2012Metric_Pad1.20x1.40mm_HandSolder; LCSC C115310

Connections:
+3V3: J1.12 (3V3), J2.4, R1.2, R2.2
+5V: J1.7 (5V)
GND: J1.11 (GND), J2.3
GPIO_AD1: J1.6 (GP_AD1), J2.2
GPIO_AD2: J1.4 (GP_AD2), J2.1
MISO: J1.2 (MISO)
MOSI: J1.5 (MOSI)
SCL: J1.9 (SCL), J2.5, R1.1
SCLK: J1.1 (SCLK)
SDA: J1.10 (SDA), J2.6, R2.1
SPI_CS: J1.3 (SPI_CS)
rgb_led_in: J1.8 (RGB_DO)

Notes on the sheet:
GND
RST
SCL
Note that there are two symbols for the VIK connector, one for keyboards, and one for modules. Be sure to use the appropriate one.
azoteq-tps pads for pcb connection
3V3
SDA
VIK module connector
RDY

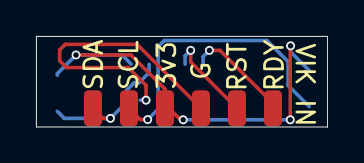
[picture p25: board azoteq-tps.kicad_pcb from above]

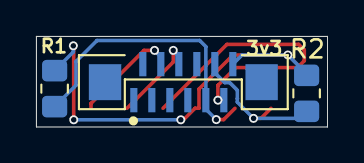
[picture p26: board azoteq-tps.kicad_pcb from below]

Board: 2 copper layers, 16.2 x 5.0 mm, 4 parts (3 on the bottom side), 6 nets.
