sadekbaroudi/vik/pcb/vik-universal/jumper-input-output-matrix/vik-universal.kicad_pcb

## KiCad design pcb/vik-universal/jumper-input-output-matrix/vik-universal.kicad_pcb (2024-01-02)

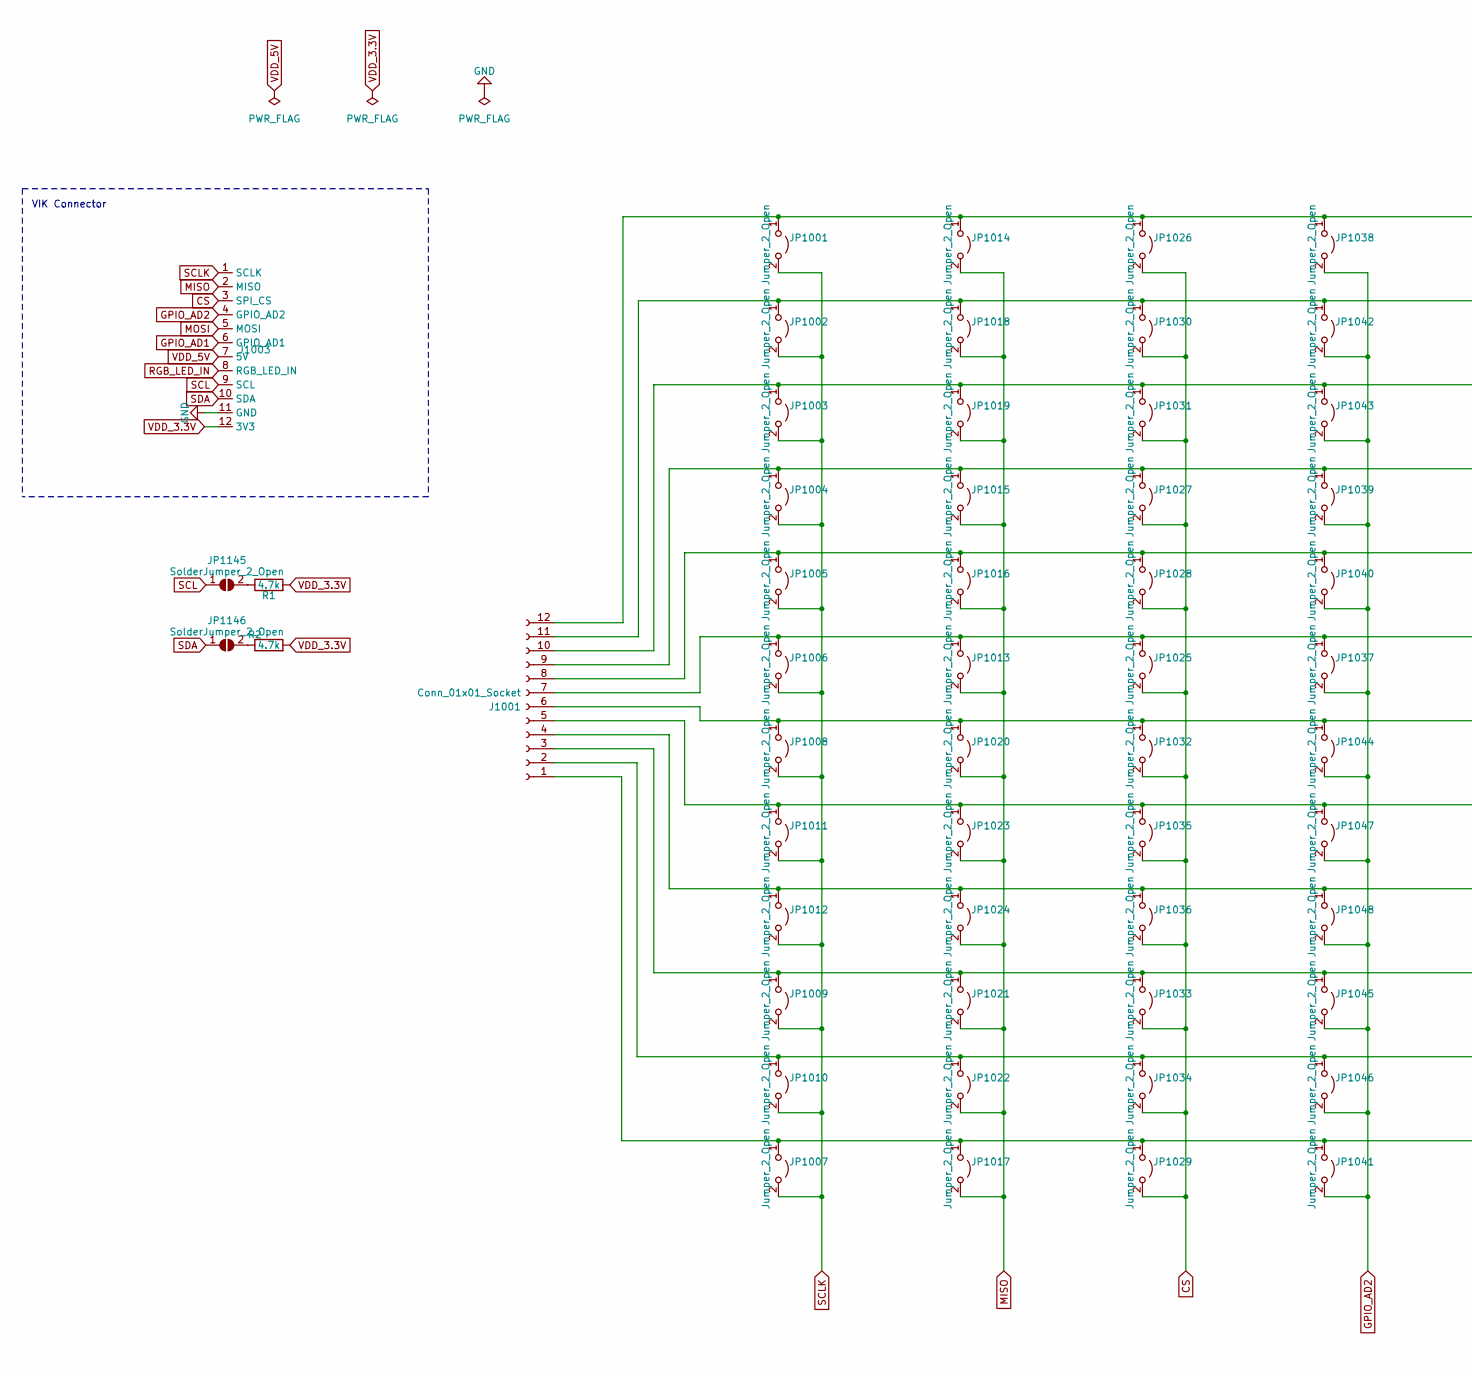
[picture p27: schematic vik-universal.kicad_sch, part in row 1, column 1]

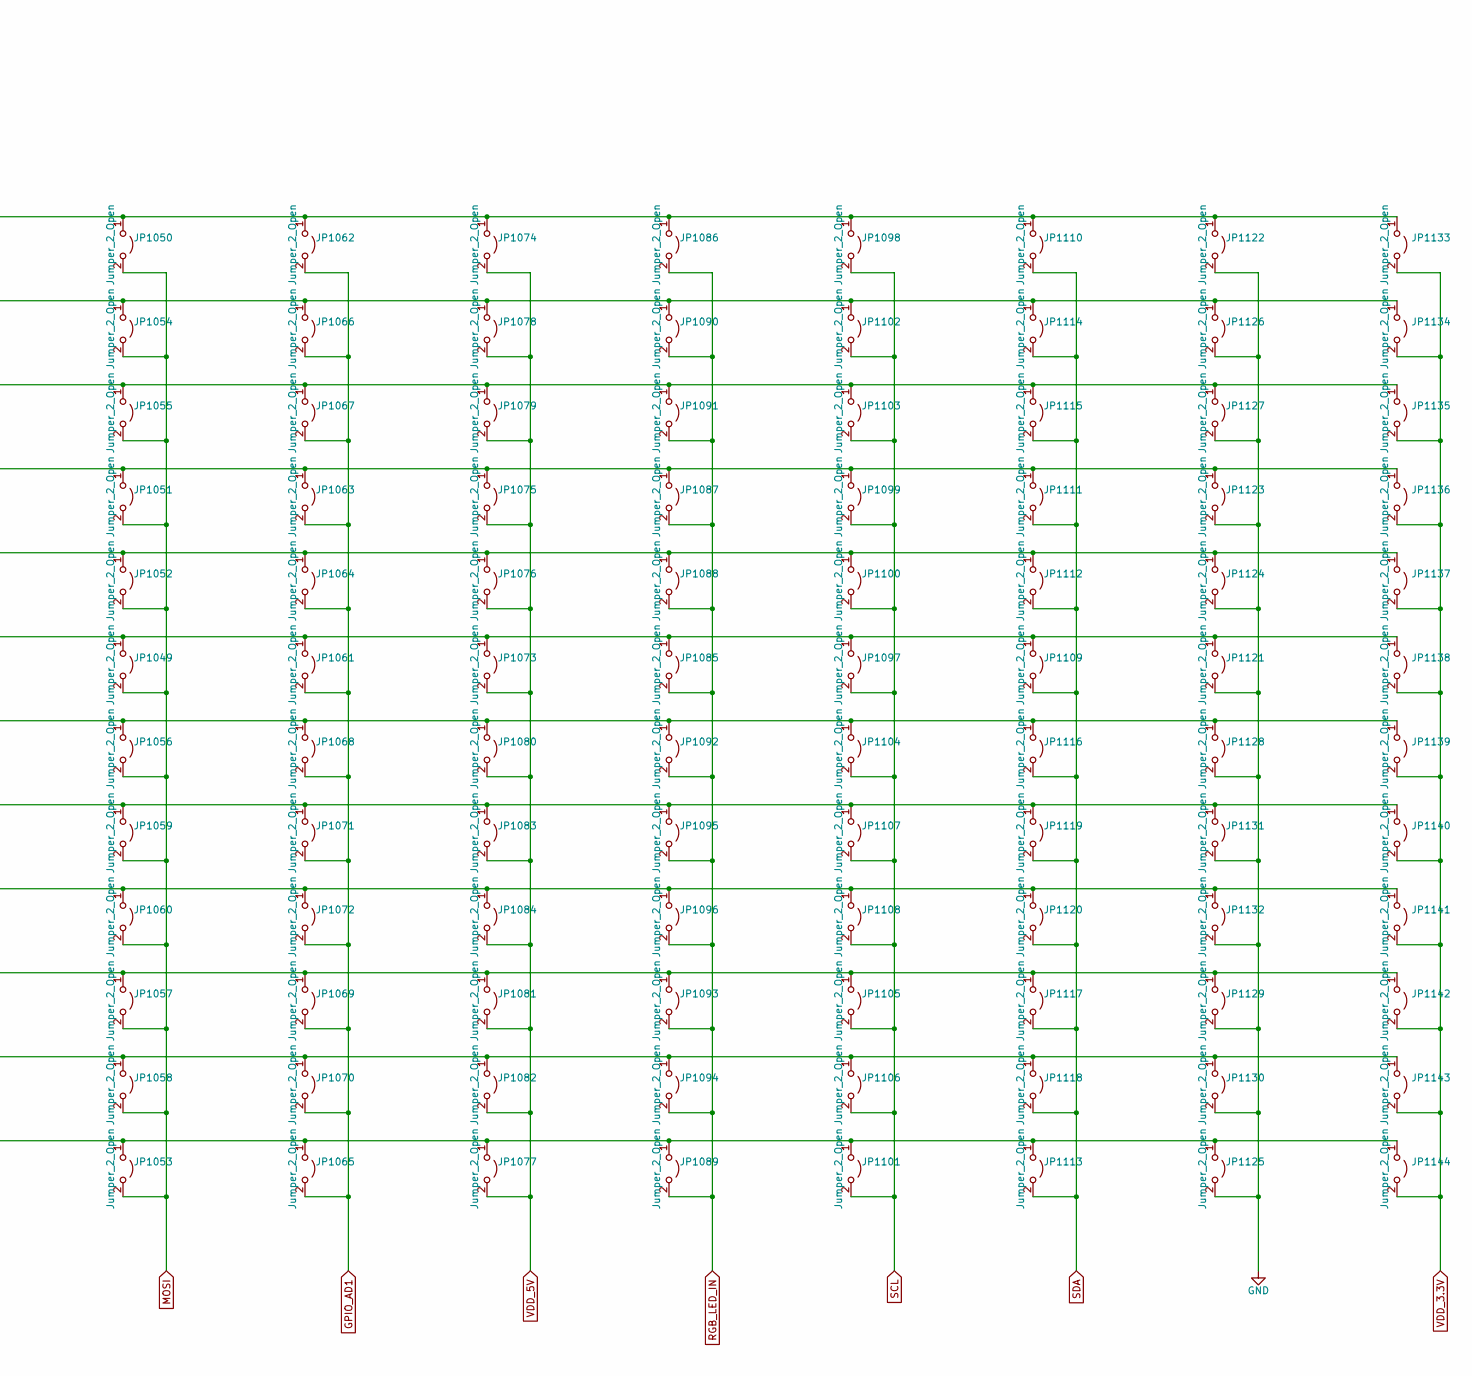
[picture p28: schematic vik-universal.kicad_sch, part in row 1, column 2]

Parts:
J1001: Conn_01x01_Socket; PinSocket_1x12_P2.54mm_Vertical
J1003: vik-module-connector-horizontal; LCSC C2919557
JP1001, JP1002, JP1003, JP1004, JP1005, JP1006, JP1007, JP1008, JP1009, JP1010, JP1011, JP1012, JP1013, JP1014, JP1015, JP1016, JP1017, JP1018, JP1019, JP1020, JP1021, JP1022, JP1023, JP1024, JP1025, JP1026, JP1027, JP1028, JP1029, JP1030, JP1031, JP1032, JP1033, JP1034, JP1035, JP1036, JP1037, JP1038, JP1039, JP1040, JP1041, JP1042, JP1043, JP1044, JP1045, JP1046, JP1047, JP1048, JP1049, JP1050, JP1051, JP1052, JP1053, JP1054, JP1055, JP1056, JP1057, JP1058, JP1059, JP1060, JP1061, JP1062, JP1063, JP1064, JP1065, JP1066, JP1067, JP1068, JP1069, JP1070, JP1071, JP1072, JP1073, JP1074, JP1075, JP1076, JP1077, JP1078, JP1079, JP1080, JP1081, JP1082, JP1083, JP1084, JP1085, JP1086, JP1087, JP1088, JP1089, JP1090, JP1091, JP1092, JP1093, JP1094, JP1095, JP1096, JP1097, JP1098, JP1099, JP1100, JP1101, JP1102, JP1103, JP1104, JP1105, JP1106, JP1107, JP1108, JP1109, JP1110, JP1111, JP1112, JP1113, JP1114, JP1115, JP1116, JP1117, JP1118, JP1119, JP1120, JP1121, JP1122, JP1123, JP1124, JP1125, JP1126, JP1127, JP1128, JP1129, JP1130, JP1131, JP1132, JP1133, JP1134, JP1135, JP1136, JP1137, JP1138, JP1139, JP1140, JP1141, JP1142, JP1143, JP1144: Jumper_2_Open; SolderJumper-2_P1.3mm_Open_RoundedPad1.0x1.5mm
JP1145, JP1146: SolderJumper_2_Open; SolderJumper-2_P1.3mm_Open_RoundedPad1.0x1.5mm
R1, R2: 4.7k; D3_TH_SMD; LCSC C104821

Connections:
CS: J1003.3 (SPI_CS), JP1025.2 (B), JP1026.2 (B), JP1027.2 (B), JP1028.2 (B), JP1029.2 (B), JP1030.2 (B), JP1031.2 (B), JP1032.2 (B), JP1033.2 (B), JP1034.2 (B), JP1035.2 (B), JP1036.2 (B)
GND: J1003.11 (GND), JP1121.2 (B), JP1122.2 (B), JP1123.2 (B), JP1124.2 (B), JP1125.2 (B), JP1126.2 (B), JP1127.2 (B), JP1128.2 (B), JP1129.2 (B), JP1130.2 (B), JP1131.2 (B), JP1132.2 (B)
GPIO_AD1: J1003.6 (GPIO_AD1), JP1061.2 (B), JP1062.2 (B), JP1063.2 (B), JP1064.2 (B), JP1065.2 (B), JP1066.2 (B), JP1067.2 (B), JP1068.2 (B), JP1069.2 (B), JP1070.2 (B), JP1071.2 (B), JP1072.2 (B)
GPIO_AD2: J1003.4 (GPIO_AD2), JP1037.2 (B), JP1038.2 (B), JP1039.2 (B), JP1040.2 (B), JP1041.2 (B), JP1042.2 (B), JP1043.2 (B), JP1044.2 (B), JP1045.2 (B), JP1046.2 (B), JP1047.2 (B), JP1048.2 (B)
MISO: J1003.2 (MISO), JP1013.2 (B), JP1014.2 (B), JP1015.2 (B), JP1016.2 (B), JP1017.2 (B), JP1018.2 (B), JP1019.2 (B), JP1020.2 (B), JP1021.2 (B), JP1022.2 (B), JP1023.2 (B), JP1024.2 (B)
MOSI: J1003.5 (MOSI), JP1049.2 (B), JP1050.2 (B), JP1051.2 (B), JP1052.2 (B), JP1053.2 (B), JP1054.2 (B), JP1055.2 (B), JP1056.2 (B), JP1057.2 (B), JP1058.2 (B), JP1059.2 (B), JP1060.2 (B)
unnamed: J1001.1, JP1007.1 (A), JP1017.1 (A), JP1029.1 (A), JP1041.1 (A), JP1053.1 (A), JP1065.1 (A), JP1077.1 (A), JP1089.1 (A), JP1101.1 (A), JP1113.1 (A), JP1125.1 (A), JP1144.1 (A)
unnamed: J1001.2, JP1010.1 (A), JP1022.1 (A), JP1034.1 (A), JP1046.1 (A), JP1058.1 (A), JP1070.1 (A), JP1082.1 (A), JP1094.1 (A), JP1106.1 (A), JP1118.1 (A), JP1130.1 (A), JP1143.1 (A)
unnamed: J1001.3, JP1009.1 (A), JP1021.1 (A), JP1033.1 (A), JP1045.1 (A), JP1057.1 (A), JP1069.1 (A), JP1081.1 (A), JP1093.1 (A), JP1105.1 (A), JP1117.1 (A), JP1129.1 (A), JP1142.1 (A)
unnamed: J1001.4, JP1012.1 (A), JP1024.1 (A), JP1036.1 (A), JP1048.1 (A), JP1060.1 (A), JP1072.1 (A), JP1084.1 (A), JP1096.1 (A), JP1108.1 (A), JP1120.1 (A), JP1132.1 (A), JP1141.1 (A)
unnamed: J1001.5, JP1011.1 (A), JP1023.1 (A), JP1035.1 (A), JP1047.1 (A), JP1059.1 (A), JP1071.1 (A), JP1083.1 (A), JP1095.1 (A), JP1107.1 (A), JP1119.1 (A), JP1131.1 (A), JP1140.1 (A)
unnamed: J1001.6, JP1008.1 (A), JP1020.1 (A), JP1032.1 (A), JP1044.1 (A), JP1056.1 (A), JP1068.1 (A), JP1080.1 (A), JP1092.1 (A), JP1104.1 (A), JP1116.1 (A), JP1128.1 (A), JP1139.1 (A)
unnamed: J1001.7, JP1006.1 (A), JP1013.1 (A), JP1025.1 (A), JP1037.1 (A), JP1049.1 (A), JP1061.1 (A), JP1073.1 (A), JP1085.1 (A), JP1097.1 (A), JP1109.1 (A), JP1121.1 (A), JP1138.1 (A)
unnamed: J1001.8, JP1005.1 (A), JP1016.1 (A), JP1028.1 (A), JP1040.1 (A), JP1052.1 (A), JP1064.1 (A), JP1076.1 (A), JP1088.1 (A), JP1100.1 (A), JP1112.1 (A), JP1124.1 (A), JP1137.1 (A)
unnamed: J1001.9, JP1004.1 (A), JP1015.1 (A), JP1027.1 (A), JP1039.1 (A), JP1051.1 (A), JP1063.1 (A), JP1075.1 (A), JP1087.1 (A), JP1099.1 (A), JP1111.1 (A), JP1123.1 (A), JP1136.1 (A)
unnamed: J1001.10, JP1003.1 (A), JP1019.1 (A), JP1031.1 (A), JP1043.1 (A), JP1055.1 (A), JP1067.1 (A), JP1079.1 (A), JP1091.1 (A), JP1103.1 (A), JP1115.1 (A), JP1127.1 (A), JP1135.1 (A)
unnamed: J1001.11, JP1002.1 (A), JP1018.1 (A), JP1030.1 (A), JP1042.1 (A), JP1054.1 (A), JP1066.1 (A), JP1078.1 (A), JP1090.1 (A), JP1102.1 (A), JP1114.1 (A), JP1126.1 (A), JP1134.1 (A)
unnamed: J1001.12, JP1001.1 (A), JP1014.1 (A), JP1026.1 (A), JP1038.1 (A), JP1050.1 (A), JP1062.1 (A), JP1074.1 (A), JP1086.1 (A), JP1098.1 (A), JP1110.1 (A), JP1122.1 (A), JP1133.1 (A)
unnamed 18: JP1145.2 (B); also elsewhere on the board
unnamed 19: JP1146.2 (B); also elsewhere on the board
RGB_LED_IN: J1003.8 (RGB_LED_IN), JP1085.2 (B), JP1086.2 (B), JP1087.2 (B), JP1088.2 (B), JP1089.2 (B), JP1090.2 (B), JP1091.2 (B), JP1092.2 (B), JP1093.2 (B), JP1094.2 (B), JP1095.2 (B), JP1096.2 (B)
SCL: J1003.9 (SCL), JP1097.2 (B), JP1098.2 (B), JP1099.2 (B), JP1100.2 (B), JP1101.2 (B), JP1102.2 (B), JP1103.2 (B), JP1104.2 (B), JP1105.2 (B), JP1106.2 (B), JP1107.2 (B), JP1108.2 (B), JP1145.1 (A)
SCLK: J1003.1 (SCLK), JP1001.2 (B), JP1002.2 (B), JP1003.2 (B), JP1004.2 (B), JP1005.2 (B), JP1006.2 (B), JP1007.2 (B), JP1008.2 (B), JP1009.2 (B), JP1010.2 (B), JP1011.2 (B), JP1012.2 (B)
SDA: J1003.10 (SDA), JP1109.2 (B), JP1110.2 (B), JP1111.2 (B), JP1112.2 (B), JP1113.2 (B), JP1114.2 (B), JP1115.2 (B), JP1116.2 (B), JP1117.2 (B), JP1118.2 (B), JP1119.2 (B), JP1120.2 (B), JP1146.1 (A)
VDD_3.3V: J1003.12 (3V3), JP1133.2 (B), JP1134.2 (B), JP1135.2 (B), JP1136.2 (B), JP1137.2 (B), JP1138.2 (B), JP1139.2 (B), JP1140.2 (B), JP1141.2 (B), JP1142.2 (B), JP1143.2 (B), JP1144.2 (B); also elsewhere on the board
VDD_5V: J1003.7 (5V), JP1073.2 (B), JP1074.2 (B), JP1075.2 (B), JP1076.2 (B), JP1077.2 (B), JP1078.2 (B), JP1079.2 (B), JP1080.2 (B), JP1081.2 (B), JP1082.2 (B), JP1083.2 (B), JP1084.2 (B)

Notes on the sheet:
VIK Connector

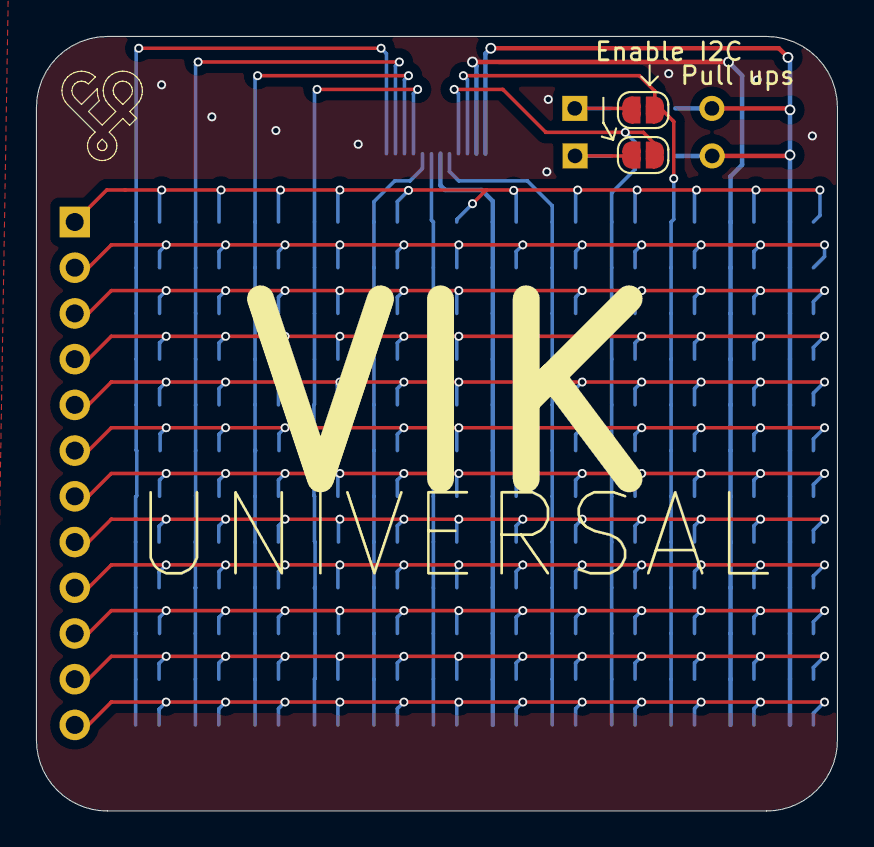
[picture p29: board pcb/vik-universal/jumper-input-output-matrix/vik-universal.kicad_pcb from above]

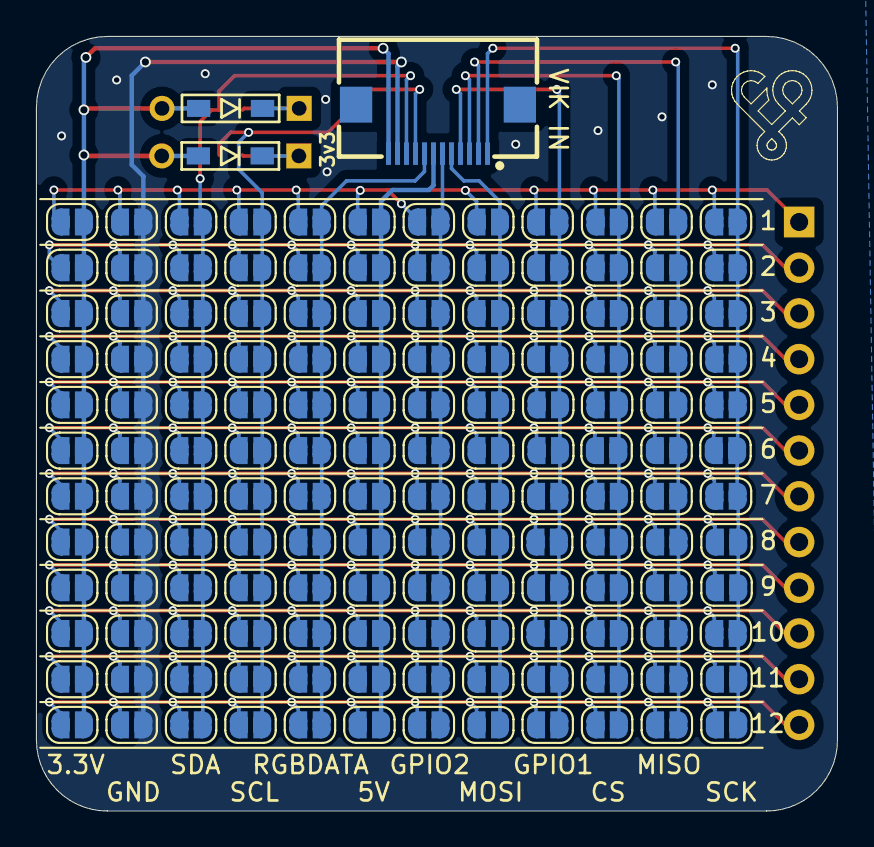
[picture p30: board pcb/vik-universal/jumper-input-output-matrix/vik-universal.kicad_pcb from below]

Board: 2 copper layers, 44.5 x 43.0 mm, 150 parts (148 on the bottom side), 26 nets.

Other parts of the board:
R1001, R1002: 4.7k; D3_TH_SMD

Their connections:
unnamed 18: R1001.1; also elsewhere on the board
unnamed 19: R1002.1; also elsewhere on the board
VDD_3.3V: R1001.2, R1002.2; also elsewhere on the board
