sadekbaroudi/vik/pcb/vik-universal/handwire/vik-universal.kicad_pcb

## KiCad design pcb/vik-universal/handwire/vik-universal.kicad_pcb (2024-01-02)

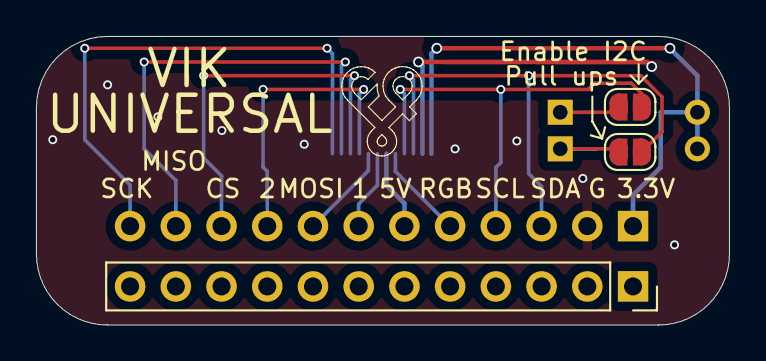
[picture p31: board pcb/vik-universal/handwire/vik-universal.kicad_pcb from above]

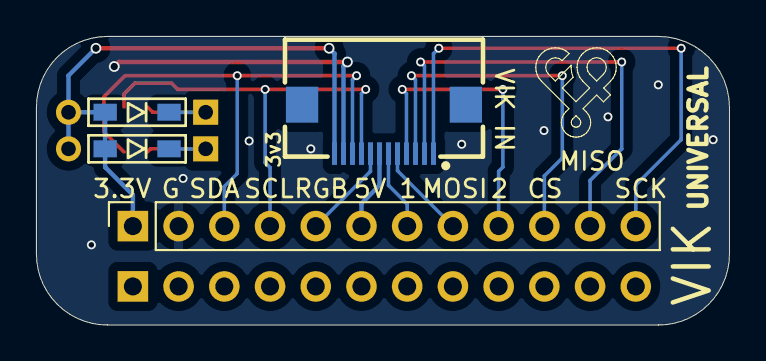
[picture p32: board pcb/vik-universal/handwire/vik-universal.kicad_pcb from below]

Board: 2 copper layers, 38.5 x 16.0 mm, 7 parts (4 on the bottom side), 14 nets.

Parts:
J1001, J1002: Conn_01x01_Socket; PinSocket_1x12_P2.54mm_Vertical
J1003: vik-module-connector-horizontal
JP1001, JP1002: SolderJumper_2_Open; SolderJumper-2_P1.3mm_Open_RoundedPad1.0x1.5mm
R1001, R1002: 4.7k; D3_TH_SMD

Connections:
CS: J1001.10, J1003.3 (SPI_CS)
GND: J1001.2, J1003.11 (GND)
GPIO_AD1: J1001.7, J1003.6 (GPIO_AD1)
GPIO_AD2: J1001.9, J1003.4 (GPIO_AD2)
MISO: J1001.11, J1003.2 (MISO)
MOSI: J1001.8, J1003.5 (MOSI)
unnamed: JP1001.2 (B), R1001.1
unnamed: JP1002.2 (B), R1002.1
RGB_LED_IN: J1001.5, J1003.8 (RGB_LED_IN)
SCL: J1001.4, J1003.9 (SCL), JP1001.1 (A)
SCLK: J1001.12, J1003.1 (SCLK)
SDA: J1001.3, J1003.10 (SDA), JP1002.1 (A)
VDD_3.3V: J1001.1, J1003.12 (3V3), R1001.2, R1002.2
VDD_5V: J1001.6, J1003.7 (5V)
