sadekbaroudi/vik/pcb/vik-universal/breadboard/vik-universal.kicad_pcb

## KiCad design pcb/vik-universal/breadboard/vik-universal.kicad_pcb (2024-01-01)

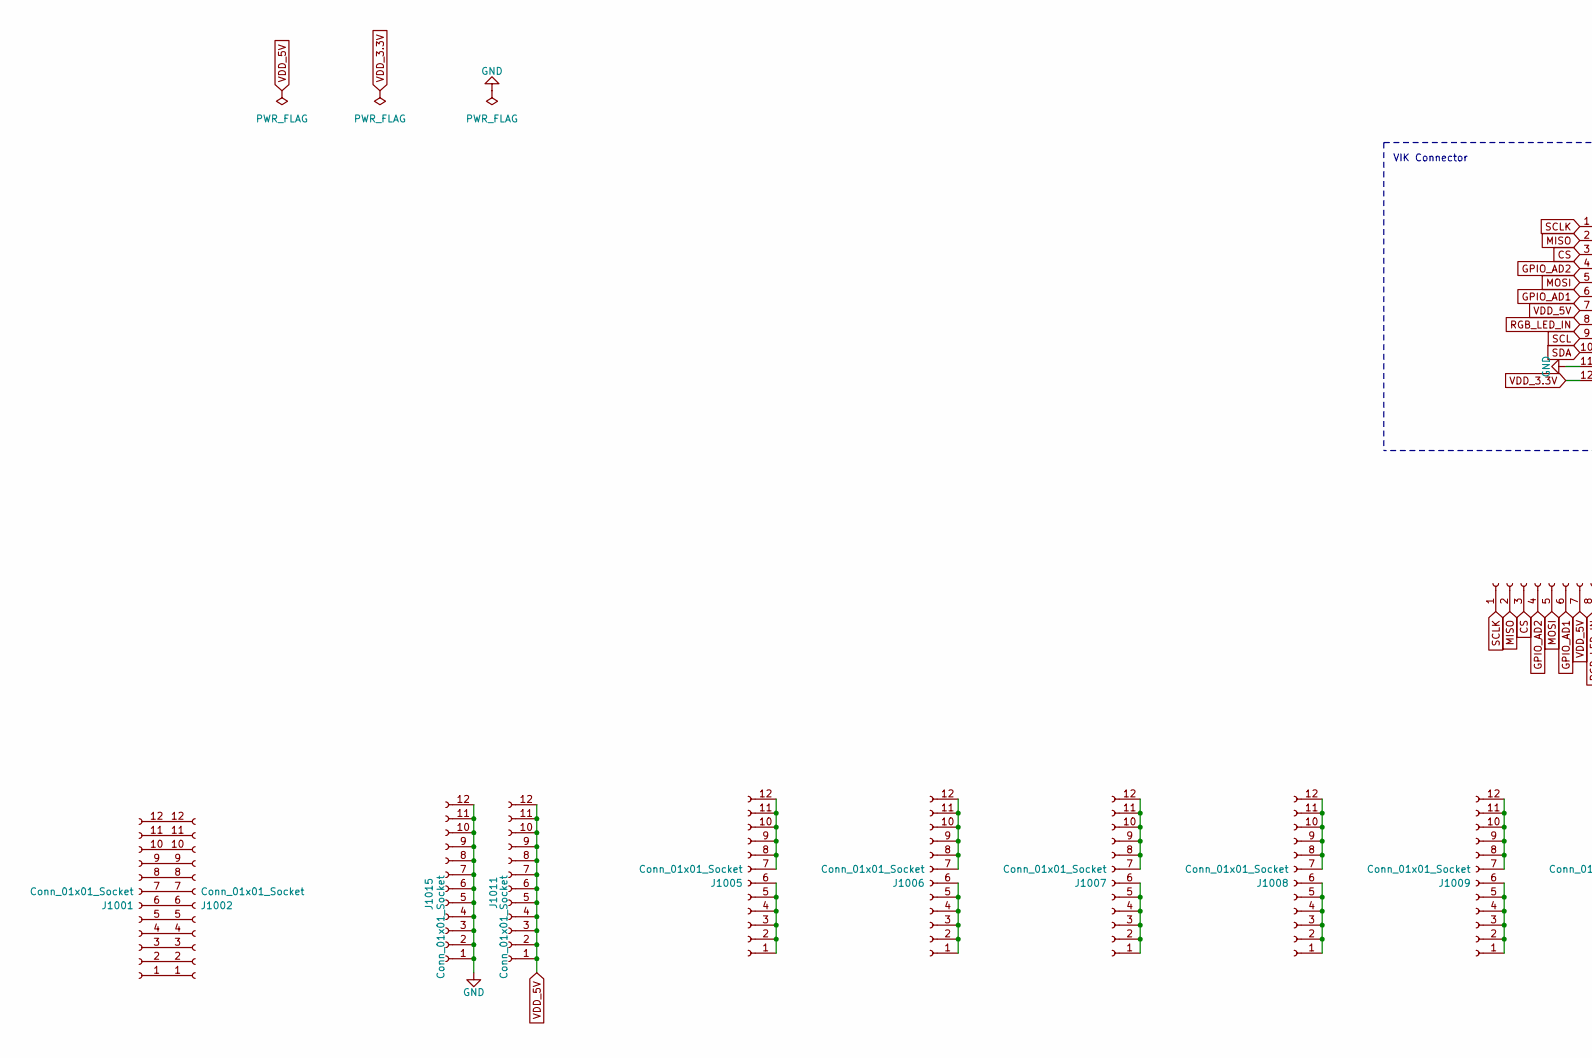
[picture p35: schematic vik-universal.kicad_sch, part in row 1, column 1]

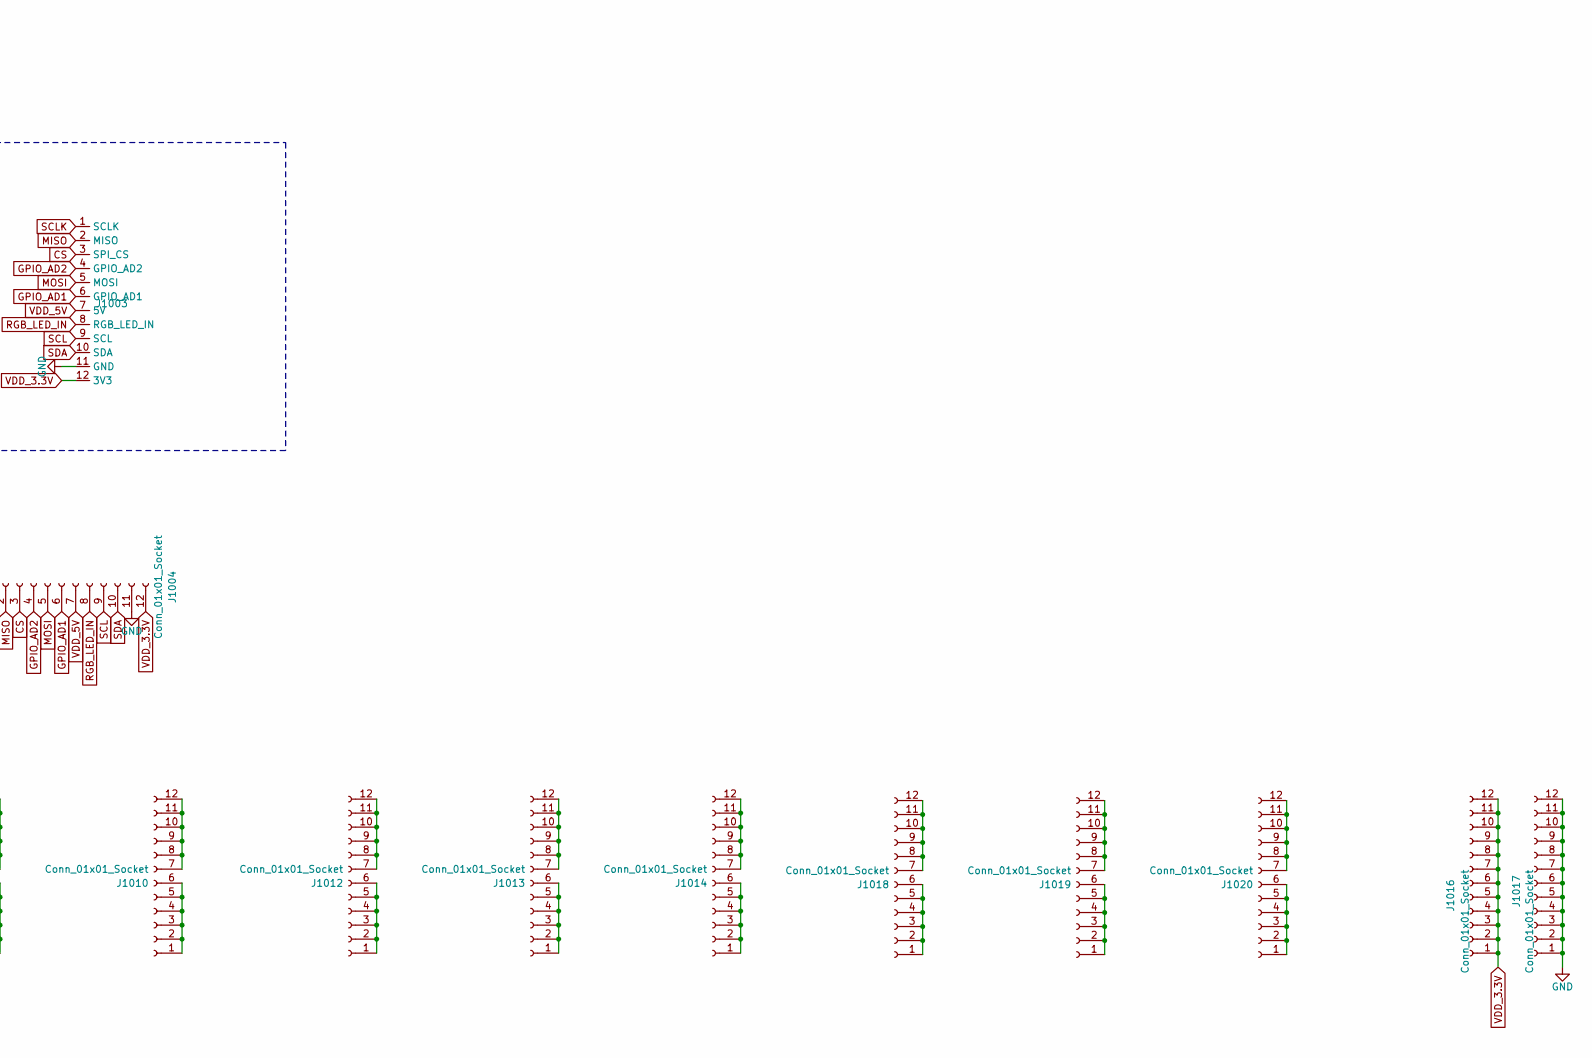
[picture p36: schematic vik-universal.kicad_sch, part in row 1, column 2]

Parts:
J1001, J1002: Conn_01x01_Socket; PinSocket_1x12_P2.54mm_Vertical_NoSilk
J1003: vik-module-connector-horizontal; LCSC C2919557
J1004: Conn_01x01_Socket; PinSocket_1x12_P2.54mm_Vertical_IndividualSilk
J1005, J1006, J1007, J1008, J1009, J1010, J1012, J1013, J1014, J1018, J1019, J1020: Conn_01x01_Socket; PinSocket_1x12_P2.54mm_Vertical_6x6_SplitSilk
J1011, J1015, J1016, J1017: Conn_01x01_Socket; PinSocket_1x12_P2.54mm_Vertical_FullSilk

Connections:
CS: J1003.3 (SPI_CS), J1004.3
GND: J1003.11 (GND), J1004.11, J1015.1, J1015.2, J1015.3, J1015.4, J1015.5, J1015.6, J1015.7, J1015.8, J1015.9, J1015.10, J1015.11, J1015.12, J1017.1, J1017.2, J1017.3, J1017.4, J1017.5, J1017.6, J1017.7, J1017.8, J1017.9, J1017.10, J1017.11, J1017.12
GPIO_AD1: J1003.6 (GPIO_AD1), J1004.6
GPIO_AD2: J1003.4 (GPIO_AD2), J1004.4
MISO: J1003.2 (MISO), J1004.2
MOSI: J1003.5 (MOSI), J1004.5
unnamed: J1001.1, J1002.1
unnamed: J1001.2, J1002.2
unnamed: J1001.3, J1002.3
unnamed: J1001.4, J1002.4
unnamed: J1001.5, J1002.5
unnamed: J1001.6, J1002.6
unnamed: J1001.7, J1002.7
unnamed: J1001.8, J1002.8
unnamed: J1001.9, J1002.9
unnamed: J1001.10, J1002.10
unnamed: J1001.11, J1002.11
unnamed: J1001.12, J1002.12
unnamed: J1005.1, J1005.2, J1005.3, J1005.4, J1005.5, J1005.6
unnamed: J1005.7, J1005.8, J1005.9, J1005.10, J1005.11, J1005.12
unnamed: J1006.1, J1006.2, J1006.3, J1006.4, J1006.5, J1006.6
unnamed: J1006.7, J1006.8, J1006.9, J1006.10, J1006.11, J1006.12
unnamed: J1007.1, J1007.2, J1007.3, J1007.4, J1007.5, J1007.6
unnamed: J1007.7, J1007.8, J1007.9, J1007.10, J1007.11, J1007.12
unnamed: J1008.1, J1008.2, J1008.3, J1008.4, J1008.5, J1008.6
unnamed: J1008.7, J1008.8, J1008.9, J1008.10, J1008.11, J1008.12
unnamed: J1009.1, J1009.2, J1009.3, J1009.4, J1009.5, J1009.6
unnamed: J1009.7, J1009.8, J1009.9, J1009.10, J1009.11, J1009.12
unnamed: J1010.1, J1010.2, J1010.3, J1010.4, J1010.5, J1010.6
unnamed: J1010.7, J1010.8, J1010.9, J1010.10, J1010.11, J1010.12
unnamed: J1012.1, J1012.2, J1012.3, J1012.4, J1012.5, J1012.6
unnamed: J1012.7, J1012.8, J1012.9, J1012.10, J1012.11, J1012.12
unnamed: J1013.1, J1013.2, J1013.3, J1013.4, J1013.5, J1013.6
unnamed: J1013.7, J1013.8, J1013.9, J1013.10, J1013.11, J1013.12
unnamed: J1014.1, J1014.2, J1014.3, J1014.4, J1014.5, J1014.6
unnamed: J1014.7, J1014.8, J1014.9, J1014.10, J1014.11, J1014.12
unnamed: J1018.1, J1018.2, J1018.3, J1018.4, J1018.5, J1018.6
unnamed: J1018.7, J1018.8, J1018.9, J1018.10, J1018.11, J1018.12
unnamed: J1019.1, J1019.2, J1019.3, J1019.4, J1019.5, J1019.6
unnamed: J1019.7, J1019.8, J1019.9, J1019.10, J1019.11, J1019.12
unnamed: J1020.1, J1020.2, J1020.3, J1020.4, J1020.5, J1020.6
unnamed: J1020.7, J1020.8, J1020.9, J1020.10, J1020.11, J1020.12
RGB_LED_IN: J1003.8 (RGB_LED_IN), J1004.8
SCL: J1003.9 (SCL), J1004.9
SCLK: J1003.1 (SCLK), J1004.1
SDA: J1003.10 (SDA), J1004.10
VDD_3.3V: J1003.12 (3V3), J1004.12, J1016.1, J1016.2, J1016.3, J1016.4, J1016.5, J1016.6, J1016.7, J1016.8, J1016.9, J1016.10, J1016.11, J1016.12
VDD_5V: J1003.7 (5V), J1004.7, J1011.1, J1011.2, J1011.3, J1011.4, J1011.5, J1011.6, J1011.7, J1011.8, J1011.9, J1011.10, J1011.11, J1011.12

Notes on the sheet:
VIK Connector

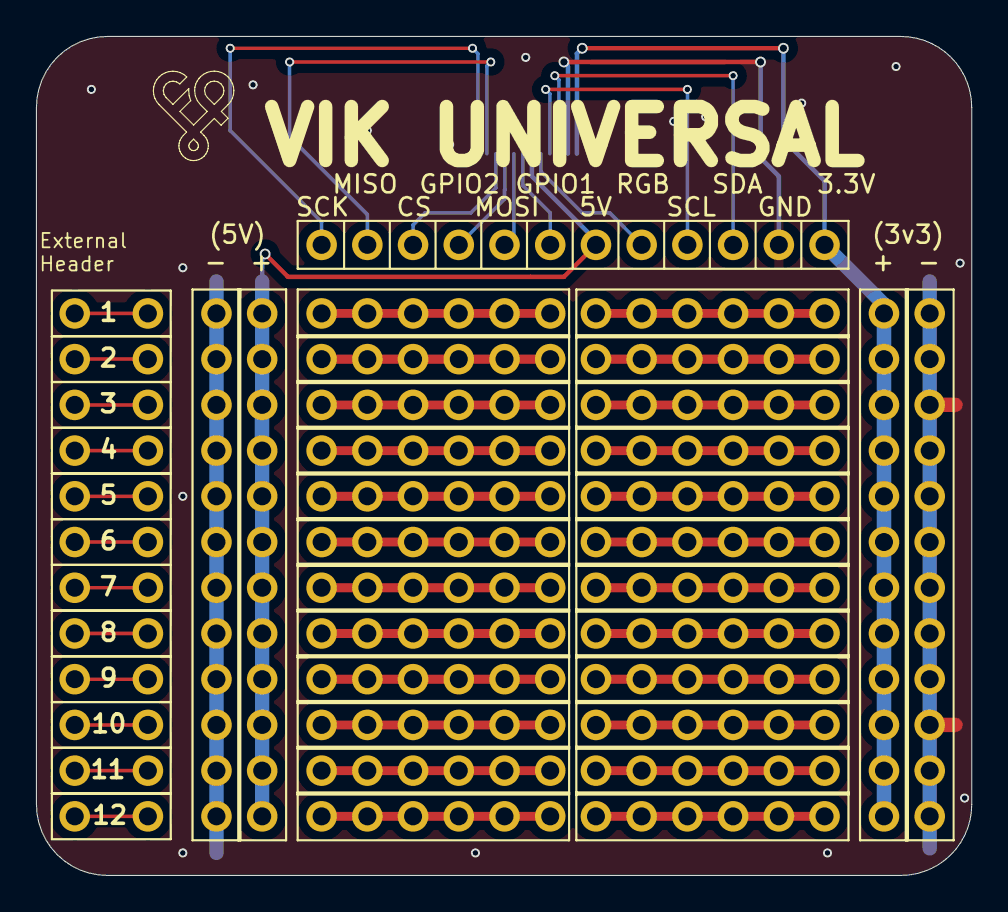
[picture p37: board pcb/vik-universal/breadboard/vik-universal.kicad_pcb from above]

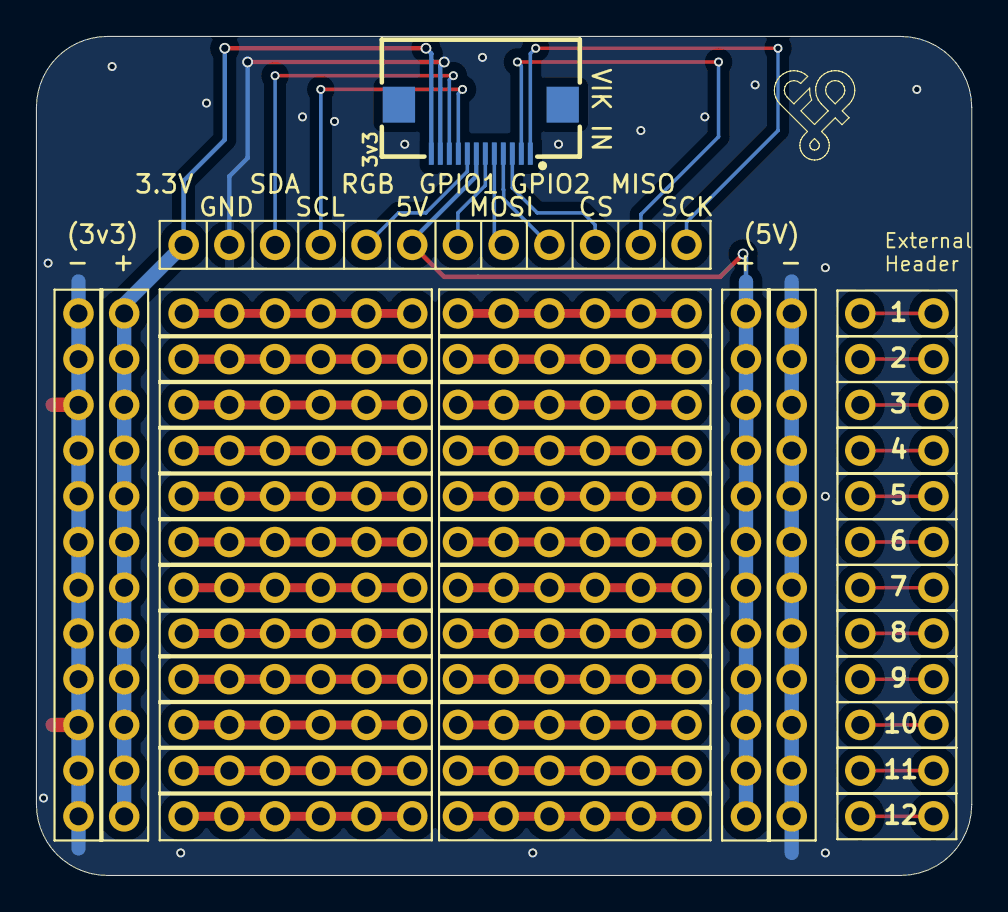
[picture p38: board pcb/vik-universal/breadboard/vik-universal.kicad_pcb from below]

Board: 2 copper layers, 52.0 x 46.6 mm, 20 parts (2 on the bottom side), 48 nets.
