sadekbaroudi/vik/pcb/joysticks/joysticks.kicad_pcb

## KiCad design pcb/joysticks/joysticks.kicad_pcb (2023-12-11)

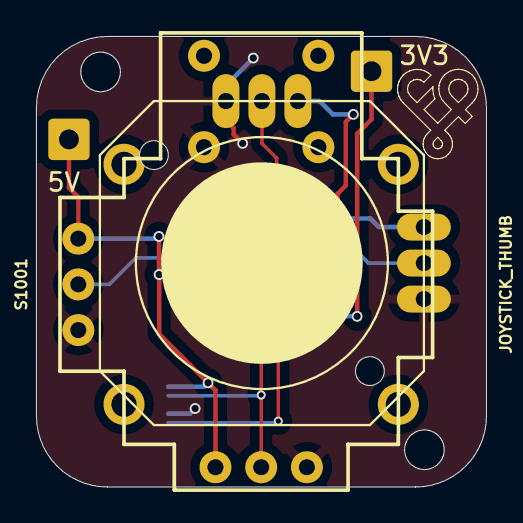
[picture p42: board joysticks.kicad_pcb from above]

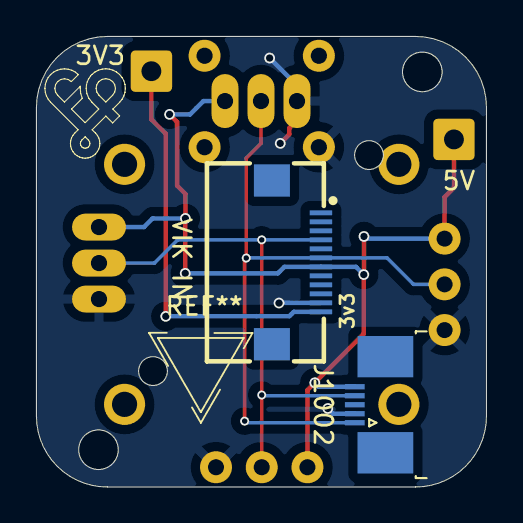
[picture p43: board joysticks.kicad_pcb from below]

Board: 2 copper layers, 25.0 x 25.0 mm, 6 parts (2 on the bottom side), 5 nets.

Parts:
J1001, J1007: Conn_01x01_Socket; SolderWire-0.5sqmm_1x01_D0.9mm_OD2.3mm
J1002: Conn_01x05_Socket; TE_0-1734839-5_1x05-1MP_P0.5mm_Horizontal
J1003: vik-module-connector-horizontal
JOY1001: JOYSTICK_ANALOG_XY; joystick_analog_xy
S1001: JOYSTICK_THUMB; sparkfun_9032_joystick_thumb

Connections:
GND: J1002.2, J1003.11 (GND), JOY1001.X- (A), JOY1001.Y- (A), S1001.B2A (SEL-), S1001.H3 (H-), S1001.V3 (V-)
GPIO_AD1: J1002.1, J1003.6 (GPIO_AD1), JOY1001.X (S), S1001.V2 (V)
GPIO_AD2: J1002.4, J1003.4 (GPIO_AD2), JOY1001.Y (S), S1001.H2 (H)
VDD_3.3V: J1001.1, J1003.12 (3V3)
VDD_5V: J1002.5, J1003.7 (5V), J1007.1, JOY1001.X+ (E), JOY1001.Y+ (E), S1001.H1 (H+), S1001.V1 (V+)
