sadekbaroudi/vik/pcb/ec11-evqwgd001/ec11-evqwgd001.kicad_pcb

## KiCad design pcb/ec11-evqwgd001/ec11-evqwgd001.kicad_pcb (2023-12-11)

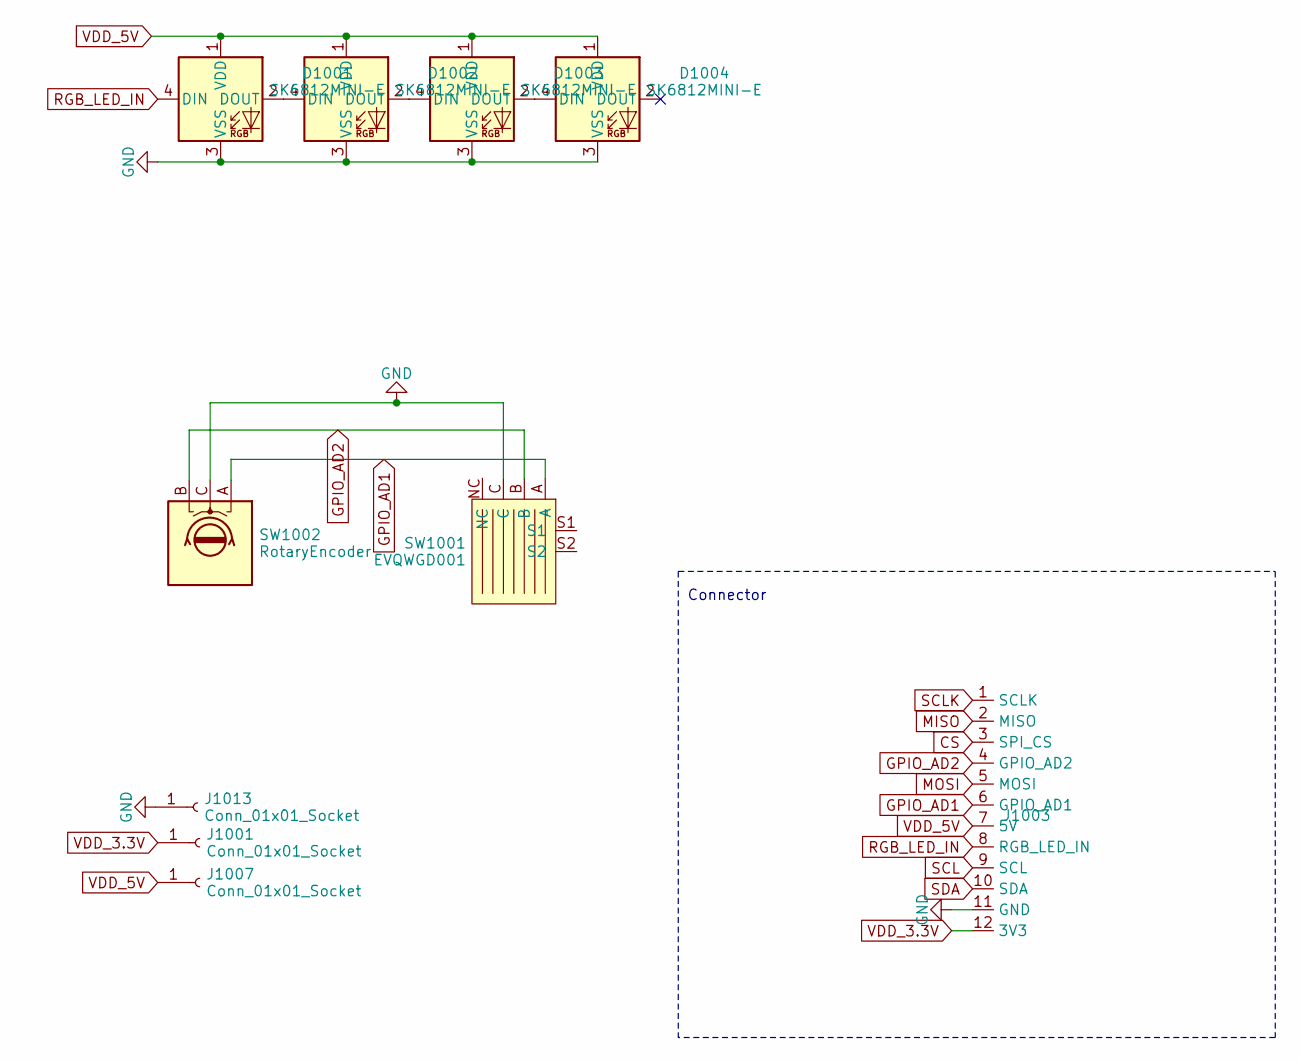
[picture p44: schematic ec11-evqwgd001.kicad_sch]

Parts:
D1001, D1002, D1003, D1004: SK6812MINI-E; SK6812MINI-E-no-switch-outline
J1001, J1007, J1013: Conn_01x01_Socket; SolderWire-0.5sqmm_1x01_D0.9mm_OD2.3mm
J1003: vik-module-connector-horizontal; LCSC C2919557
SW1001: EVQWGD001
SW1002: RotaryEncoder; RotaryEncoder_EC11-no-legs

Connections:
CS: J1003.3 (SPI_CS)
GND: D1001.3 (VSS), D1002.3 (VSS), D1003.3 (VSS), D1004.3 (VSS), J1003.11 (GND), J1013.1, SW1001.C, SW1002.C
GPIO_AD1: J1003.6 (GPIO_AD1), SW1001.A, SW1002.A
GPIO_AD2: J1003.4 (GPIO_AD2), SW1001.B, SW1002.B
MISO: J1003.2 (MISO)
MOSI: J1003.5 (MOSI)
unnamed: D1001.2 (DOUT), D1002.4 (DIN)
unnamed: D1002.2 (DOUT), D1003.4 (DIN)
unnamed: D1003.2 (DOUT), D1004.4 (DIN)
RGB_LED_IN: D1001.4 (DIN), J1003.8 (RGB_LED_IN)
SCL: J1003.9 (SCL)
SCLK: J1003.1 (SCLK)
SDA: J1003.10 (SDA)
VDD_3.3V: J1001.1, J1003.12 (3V3)
VDD_5V: D1001.1 (VDD), D1002.1 (VDD), D1003.1 (VDD), D1004.1 (VDD), J1003.7 (5V), J1007.1

Notes on the sheet:
Connector

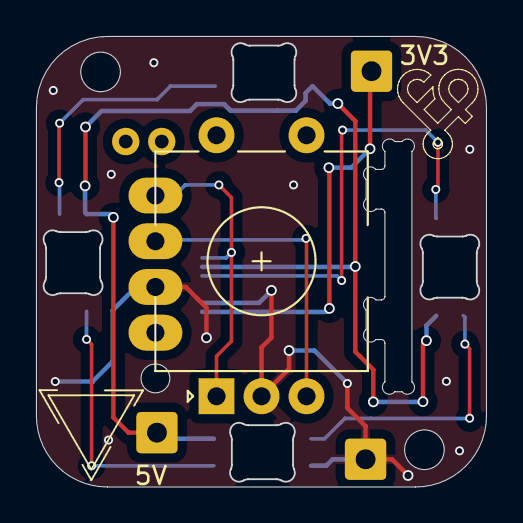
[picture p45: board ec11-evqwgd001.kicad_pcb from above]

Board: 2 copper layers, 25.0 x 25.0 mm, 10 parts (1 on the bottom side), 9 nets.
