sadekbaroudi/vik/pcb/waveshare-22224/waveshare-22224.kicad_pcb

## KiCad design pcb/waveshare-22224/waveshare-22224.kicad_pcb (2023-10-22)

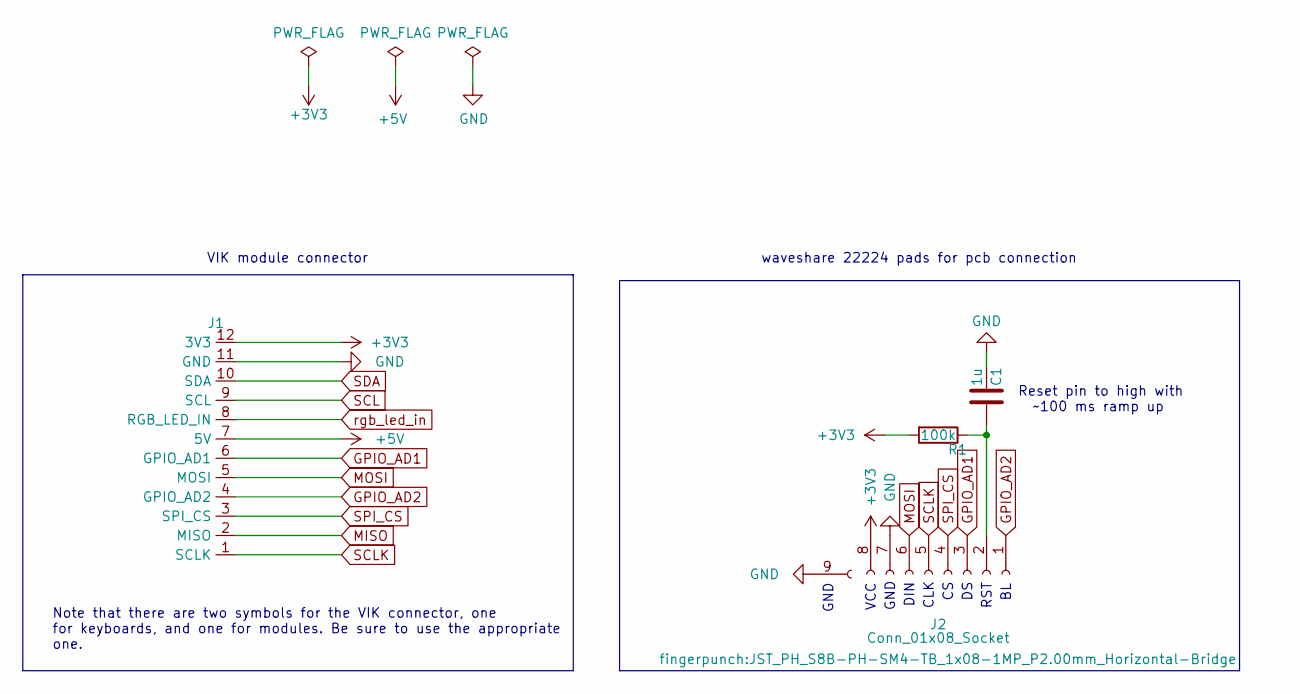
[picture p46: schematic waveshare-22224.kicad_sch]

Parts:
C1: 1u; C_0402_1005Metric; MPN CL05A105KA5NQNC; LCSC C52923
J1: vik-module-connector-horizontal; LCSC C479750
J2: Conn_01x08_Socket; JST_PH_S8B-PH-SM4-TB_1x08-1MP_P2.00mm_Horizontal-Bridge
R1: 100k; R_1206_3216Metric_Pad1.30x1.75mm_HandSolder; LCSC C17900

Connections:
+3V3: J1.12 (3V3), J2.8, R1.2
+5V: J1.7 (5V)
GND: C1.1, J1.11 (GND), J2.7, J2.9 (GND)
GPIO_AD1: J1.6 (GPIO_AD1), J2.3
GPIO_AD2: J1.4 (GPIO_AD2), J2.1
MISO: J1.2 (MISO)
MOSI: J1.5 (MOSI), J2.6
unnamed: C1.2, J2.2, R1.1
SCL: J1.9 (SCL)
SCLK: J1.1 (SCLK), J2.5
SDA: J1.10 (SDA)
SPI_CS: J1.3 (SPI_CS), J2.4
rgb_led_in: J1.8 (RGB_LED_IN)

Notes on the sheet:
DIN
RST
GND
Note that there are two symbols for the VIK connector, one for keyboards, and one for modules. Be sure to use the appropriate one.
waveshare 22224 pads for pcb connection
Reset pin to high with ~100 ms ramp up
CLK
VIK module connector
VCC

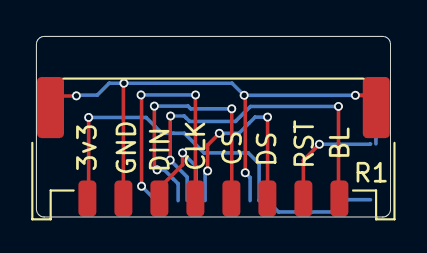
[picture p47: board waveshare-22224.kicad_pcb from above]

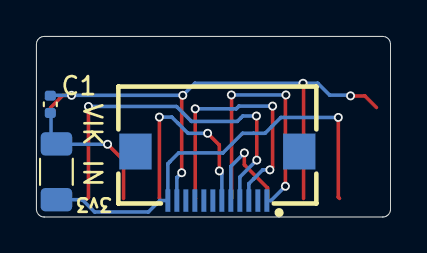
[picture p48: board waveshare-22224.kicad_pcb from below]

Board: 2 copper layers, 19.7 x 10.0 mm, 4 parts (3 on the bottom side), 8 nets.
