sadekbaroudi/vik/pcb/weact-st7735/weact-st7735.kicad_pcb

## KiCad design pcb/weact-st7735/weact-st7735.kicad_pcb (2023-08-29)

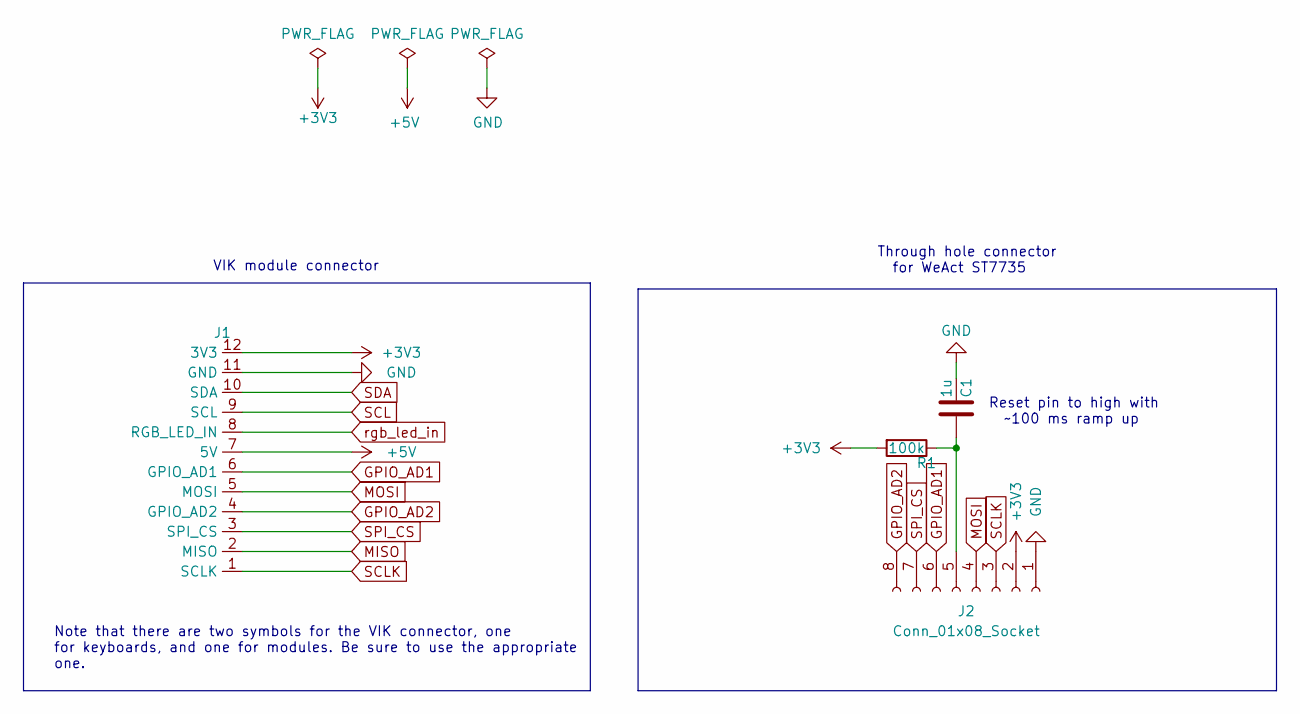
[picture p58: schematic weact-st7735.kicad_sch]

Parts:
C1: 1u; C_0402_1005Metric; MPN CL05A105KA5NQNC; LCSC C52923
J1: vik-module-connector-horizontal; LCSC C479750
J2: Conn_01x08_Socket; PinHeader_1x08_P2.54mm_Vertical
R1: 100k; R_1206_3216Metric_Pad1.30x1.75mm_HandSolder; LCSC C17900

Connections:
+3V3: J1.12 (3V3), J2.2, R1.2
+5V: J1.7 (5V)
GND: C1.1, J1.11 (GND), J2.1
GPIO_AD1: J1.6 (GPIO_AD1), J2.6
GPIO_AD2: J1.4 (GPIO_AD2), J2.8
MISO: J1.2 (MISO)
MOSI: J1.5 (MOSI), J2.4
unnamed: C1.2, J2.5, R1.1
SCL: J1.9 (SCL)
SCLK: J1.1 (SCLK), J2.3
SDA: J1.10 (SDA)
SPI_CS: J1.3 (SPI_CS), J2.7
rgb_led_in: J1.8 (RGB_LED_IN)

Notes on the sheet:
Note that there are two symbols for the VIK connector, one for keyboards, and one for modules. Be sure to use the appropriate one.
Through hole connector for WeAct ST7735
Reset pin to high with ~100 ms ramp up
VIK module connector

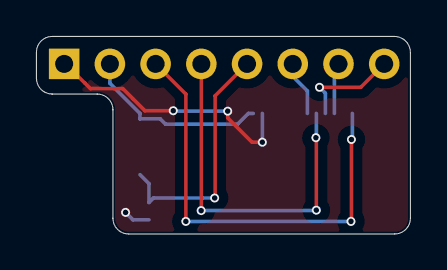
[picture p59: board weact-st7735.kicad_pcb from above]

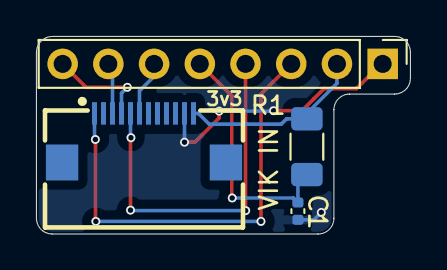
[picture p60: board weact-st7735.kicad_pcb from below]

Board: 2 copper layers, 20.8 x 11.0 mm, 4 parts (4 on the bottom side), 8 nets.
