sadekbaroudi/vik/(notices)

Notices in the files:
pcb/vik-universal/breadboard/vik-universal.kicad_sch:
Copyright Quentin Lebastard
